TijmenDC1/PE2-herexamen/scriptie en voorstelling/Flight_Controller_Scriptie.docx

Flight Controller

Ontwerp, probleemanalyse en herexamen

PE2

# 1. Inleiding

Wij hebben gekozen voor het ontwerpen van een drone. De drie grote onderdelen van een drone zijn de flight controller, de esc en de motor. De motors hebben we aangekocht de andere twee waren de bedoeling om zelf te ontwikkelen. Doorheen het semester hebben we bij beide onze problemen gehad. Er is uiteindelijk besloten om voor de herkansing in augustus te gaan voor het werkende krijgen van de flight controller en ook de esc modules aan te kopen. Ondanks dat dit een teleurstelling is zullen we in deze scriptie de esc als module nog wel aanhalen maar de eigen ontwikkeling ervan aan de kant laten.

Voor de flight controller, het brein hebben we gekozen om 2 opties te voorzien voor onze drone aan te sturen namelijk autonoom alsook met behulp van een controller beide met hun specifieke benodigde componenten als 1 gemeenschappelijke zijnde de gyroscoop.

Dit document beschrijft achtereenvolgens de gemaakte ontwerpkeuzes, de opbouw van de printplaat, de problemen die tijdens het eerste semester zijn opgetreden en hoe daarmee is omgegaan, en tot slot de voortgang die we hebben weten te boeken tijdens de herexamen periode.

# 2. Functionaliteiten

Om de drone stabiel te houden en beide vliegmodusen te ondersteunen, is de flight controller uitgerust met de volgende functionaliteiten:

### Algemene stabilisatie

### Oorspronkelijk

- BMI330 – IMU met drie accelerometers en drie gyroscopen

Alternatief

- MPU6050 – IMU module drie accelerometers en drie gyroscopen

### Autonoom vliegen

- GPS-module
- Magnetometer
- Barometer
- MicroSD-kaart voor routegegevens

### Vliegen met een controller

- 2,4 GHz-transceiver met bijhorende antenne
- Gebruik van enkele sensoren die grotendeels ook voor autonoom worden gebruikt

# 3. Ontwerpkeuzes

## 3.1 Microcontroller: STM32

Voor de verwerking van alle sensordata is gekozen voor de STM32F745VGT6. Tijdens de research zijn verschillende microcontrollers vergeleken die vaak worden toegepast in flight controllers, waaronder de lichtere STM32F411 en de krachtigere STM32H743. Uiteindelijk is de F7-variant gekozen om voldoende rekenkracht te garanderen voor de PID-regellussen en de bijhorende berekeningen. De H7 was ten eerste ontzettend duur en echt overkill voor wat wij zouden nodig hebben.

Achteraf bleek de STM32F7 ruim voldoende capaciteit te bieden voor de toepassing. Voor een toekomstige versie zou een lichtere en goedkopere chip, zoals de STM32F411, waarschijnlijk zeker hebben volstaan.

## 3.2 Sensoren

Om de drone te kunnen stabiliseren en autonoom te laten navigeren, zijn de volgende sensoren op de flight controller geïntegreerd:

Gyroscoop: voor de PID-loop en de algemene stabilisatie van de drone zijn we uiteindelijk beland bij de MPU6050 (lees paragraaf 5.4 Overstap naar de MPU6050)

Magnetometer: voor autonome navigatie is een kompas onmisbaar om de vliegrichting te bepalen. Hiervoor is de Bosch BMM350 toegepast.

Barometer: om tijdens autonome vluchten de hoogte te bepalen, maakt de flight controller gebruik van de Bosch BMP384. Deze sensor werkt op de nieuwste print wel maar we hebben geen tijd gehad om deze nog te integreren.

GPS-module: voor positionering is gekozen voor de U-blox DAN-F10N. Deze module beschikt over een geïntegreerde antenne, waardoor geen aparte antenne en RF-ontvanger op de printplaat nodig zijn. Deze is pas later aangekomen en om toch te kunnen beginnen in de vakantie is besloten om even zonder deze verder te gaan.

## 3.3 Communicatie

Voor de communicatie met de afstandsbediening is de SX1280-chip toegepast. Deze chip ondersteunt het ExpressLRS-protocol (ELRS). Deze draaien we op het LORA (long range) principe. Het is een open source protocol ontworpen voor FPV-drones. Het geeft ook de mogelijkheid om feedback van op de drone terug te sturen naar de antenne. Om de communicatie van onze drone tot stand te brengen hebben we op school gemeten met de spectrum analyzer en zagen we dat er 2.4GHz werd uitgezonden we wisten op basis hiervan dat de chip “leefde” waardoor we verder konden ontwikkelen. Dit is op het oorspronkelijke bord nooit gelukt om aan te tonen.

## 3.4 Batterij

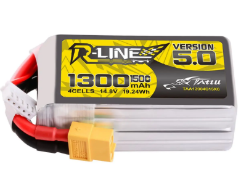
[picture p10: figure]

Om een batterij te kiezen moesten we rekening houden met enkele dingen. De belangrijkste waren de AAD (average amp Draw), AUW (all up weight) en de tijd. De tijd was natuurlijk flexibel maar het mag ook niet te kort zijn want we wouden wel een deftige vluchttijd. De andere 2 waren op voorhand moeilijk exact te bepalen zonder de componenten exact te weten en parameters zoals frame gewicht nog niet in te kunnen brengen. We vonden online enkele formules zoals: tijd = (capaciteit * discharge) / AAD en AAD = (AUW * P) / V waarbij V de nominale batterij spanning is en P het vermogen per kilogram opstijg gewicht. Dat laatste vonden we online namelijk 170 W/KG. Na een gewichtsinschatting te doen kwamen we bij een gewicht van 623g. We wouden een vliegtijd van 10 min halen wat ons op een nominale spanning van ongeveer 15 volt kwam waardoor we op een 4s LIPo batterij kwamen. (het uiteindelijke gewicht kwam uit op net geen 500 gram.)

## 3.5 Motors en propellors

De KV-waarde van een brushless dc motor (uitgedrukt in RPM/volt) geeft aan hoeveel toeren per minuut de motor onbelast draait per volt aangelegde spanning. Deze waarde is een directe ontwerpparameter: ze bepaalt in grote mate of een motor geschikt is voor snelle, wendbare toepassingen dan wel voor toepassingen met veel stuwkracht bij lagere toerentallen.

Onze kv waarde werd dus berekend met de door de batterij geleverde spanning, nominaal 14.8v. De vraag was nu hoeveel RPM we nodig hadden. Hier is de grote en hoeveelheid spaken van de propollors ook van belang. Uiteindelijk is het geen exacte wetenschap met 1 exact antwoord. Maar aangeizen kleine propellors met hoog toerental vooral nodig is voor pure snelheid en het omgekeerde voor stabiele vlucht hebben we gekozen voor een middenweg. We hebben uiteinlijk motors van 2400KV gekocht en propellors met 3 bladen.

## 3.6 ESC’s

Zoals eerder vermeld was het oorspronkelijk de bedoeling om onze eigen ESC’s te ontwikkelen. Jammer genoeg is dat niet geluk. Hoewel het aangetoond is dat het kan werken (enkele seconden) is het niet gelukt om dit consistent te laten draaien doordat we de interne buck converter van de stspin32f0a niet aan de praat kregen. Hierdoor is gekozen om ons in de herexamen te focussen op de flight controller. We zijn dan voor esc modules van aliexpress gegaan.

# 4. PCB ontwerp

# 4.1 Beschrijving

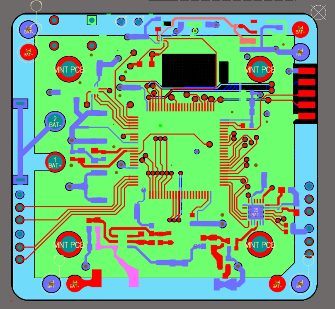
[picture p11: figure]

We hebben gekozen voor een 4 laags PCB. Dit had enkele redenen. De eerste en belangrijkste reden was om verschillende powerplanes te hebben er loopt namelijk heel wat stroom door de flight controller aangezien de esc’s ook gevoed worden vanop de FC. Het maakte het ook mogelijk om een compact design te maken wat voor een drone van uitermate belang is. Bij dit compact design kwam dan als extra voordeel dat het ook minder gewicht met zich mee bracht. Hiernaast staat een voorbeeld van 1 van de planes.

# 4.2 Schemas

In onderstaande afbeelding kan u alles sheets van het schema bekijken maar dit zijn de aansluitingen van eerder vernoemde sensors. In deze paragraaf zou ik graag verder ingaan op de power schema’s. We zien in bijlage 2 een twee traps voeding keten. De eerste trap gaan we van de batterij spanning naar de 3.3volt voedingspanning voor het over grote deel van onze fc. De esc’s worden hier trouwens niet aan verbonden dit gebeurd via de fc maar is wel op de batterij spanning. Het eerste wat we zien na de connector is een diode, deze wordt gebruikt als polariteitsbescherming om de rest van de schakeling te beschermen tegen schade bij bijvoorbeeld foutief aansluiten van de batterij. Dan zien we de effectieve buck converter. Deze werkt doordat een interne transistor razendsnel “af” en “aan” gaat door een pwm signaal aan de gate. De energie word tussendoor opgeslagen door de spoel. Als de transistor aan staat zal de stroom lineair opbouwen over de spoel en als deze af staat zal de spoel deze plotse verandering tegen gaan door stroom terug te leveren uit zijn magnetisch veld. Dit word dan nog eens afgevlakt door een condensator waardoor er een mooie vlakke spanning van 3.3 volt ontstaat.

Voor de gps-module hebben we 1.8 volt nodig omdat de trap tussen 3.3 volt en 1.8 volt niet zo groot is gebruiken we een ldo. Deze zet via een transistor en een feedback loop een vaste 1.8 volt op de uitgang het overige vermogen wordt via warmte weg gereguleerd. Als we dus veel vermogen nodig hebben zou dit niet rendabel zijn omdat we dan veel hitte ontwikkelen en onze batterij te rap leeg trekken.

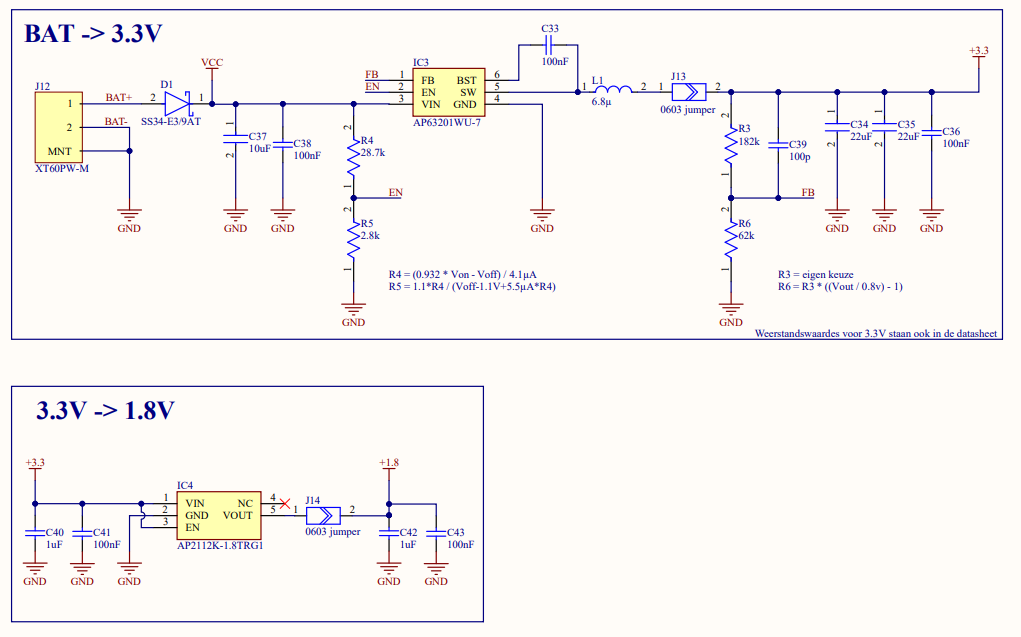
[picture p12: figure]
Afbeelding met tekst, diagram, Plan, lijn Door AI gegenereerde inhoud is mogelijk onjuist.

# 5. Problemen en troubleshooting – eerste semester

Tijdens de bouw en het testen van de printplaat is een reeks problemen aan het licht gekomen. Onderstaand overzicht beschrijft deze problemen, de oorzaak ervan en de manier waarop ze zijn aangepakt.

## 5.1 Voeding en de buck-converter

Bij het eerste testen van de printplaat bleek er geen 3,3V op het bord aanwezig te zijn. Aangezien deze spanning bijna alle sensoren en de STM32 voedt, functioneerde de print hierdoor volledig niet.

Na het testen wees uit dat dit werd veroorzaakt door een verkeerd gekozen spoel na de buck-converter. De oorspronkelijk gekozen spoel had een saturatiestroom van slechts 60 mA, terwijl de print in normaal werking al meer stroom vraagt. Om toch te kunnen testen, is de 3,3V-spanning gedurende lange tijd extern geïnjecteerd.

Bij het bestellen van een vervangende spoel is bovendien per ongeluk een metrische in plaats van een imperial 0603-behuizing besteld, waardoor in werkelijkheid een 0201-spoel werd geleverd die niet bruikbaar was. Na het bestellen van de juiste spoelen werkte de voeding naar verwachting.

## 5.2 Het 14V-incident en schade aan componenten

Tijdens het handmatig injecteren van de 3,3V-testspanning is een fout gemaakt waarbij per ongeluk tweemaal 14V op de 3,3V-voedingsrail werd gezet.

De aanwezige sensoren – de BMI330, de BMM350, de BMP384 en de GPS-module – hebben een absolute maximale spanning die ver onder deze 14V ligt. Als gevolg van dit incident zijn de geïntegreerde sensoren op de printplaat onbruikbaar geworden.

## 5.4 Overstap naar een MPU6050-module

Zoals in de functionaliteiten te lezen valt hebben we op ons bord een BMI330 voorzien echter hebben we deze tijdens de test fase beschadigd waardoor we deze niet meer konden gebruiken. De levertermijn voor deze was ontzettend ver en zelfs voor de herkansing in augustus was dit geen optie. Dankzij de tussenkomst van de docent is er gegaan voor een MPU6050 op een module ondanks dat deze chip niet meer gemaakt word is er wel een enorme hoeveelheid aan modules met deze chip op beschikbaar. Deze hebben we dan ook gesoldeerd op een I2C pin van de controller. Het grootste nadeel hieraan is dat we deze dus zo stevig en zo recht mogelijk aan het frame monteren. Of als alternatief op het recht monteren en kalibratie uitvoeren voor de vlucht.

## 5.5 Gespiegelde ST-Link footprint

Bij het ontwerpen van de footprint voor de ST-Link is de pinout gespiegeld aangebracht. Hierdoor was achteraf een extra tussenstuk nodig om de ST-Link met de STM32 te kunnen laten communiceren.

# 6. Herexamen ontwikkeling

Na het eerste semester is in het kader van het herexamen verder gewerkt aan een werkende flight controller op basis van de MPU6050 als vervangende IMU, met DShot als aansturingsprotocol voor de esc’s. Hieronder volgt een overzicht van de problemen die tijdens deze fase zijn opgetreden, telkens met het symptoom, de oorzaak en de gehanteerde oplossing.

6.1 PID

De stabilisatie van onze drone gebeurt met behulp van een PID controller. Deze code hadden we ook al ontwikkeld tijdens het semester. Oorspronkelijk hadden we 4 loops. De 3 voor de hand liggende zoals de pitch, yaw en roll van de drone dit doen we met de IMU op de drone aanwezig. We hadden er ook nog 1 voorzien voor de hoogte zeker voor het autonoom te laten vliegen is dit zeer handig en bijna essentieel, echter hadden we hier geen tijd meer voor.

Het principe van een PID-regelaar is dat op elk moment een fout (error) wordt berekend als het verschil tussen de gewenste waarde (setpoint) en de werkelijk gemeten waarde. Deze wordt dan via 3 verschillende kanalen bepaald.

- P-term (Proportioneel): reageert onmiddellijk en proportioneel op de huidige fout. Een grote afwijking levert een grote correctie op, een kleine afwijking een kleine correctie. De P-term zorgt voor de basisreactiesnelheid van de regelaar, maar kan bij een te hoge waarde leiden tot overshoot en oscillaties.
- I-term (Integrerend): houdt de opbouw van de fout over tijd bij en corrigeert voor kleine, blijvende afwijkingen die de P-term alleen niet wegwerkt. Een te hoge I-term veroorzaakt echter een trage, slingerende reactie (windup).
- D-term (Differentiërend): kijkt naar de snelheid waarmee de fout verandert en werkt dempend: ze remt de correctie af naarmate het setpoint wordt benaderd, wat overshoot en oscillaties helpt onderdrukken. Een te hoge D-term maakt de regelaar echter gevoelig voor sensorruis.

De som van deze drie termen, elk vermenigvuldigd met een eigen versterkingsfactor (Kp, Ki en Kd), bepaalt de uiteindelijke stuuruitgang die aan de motoren wordt doorgegeven via de mixer.

Van PID-uitgang naar motoraansturing

De uitgangswaarden van de drie PID-regelaars (voor roll, pitch en yaw) worden samen met de throttle-waarde van de controller/sd kaart doorgegeven aan de motormixer. Deze mixer verdeelt de correcties over de vier motoren. Het resultaat van deze mixer wordt uiteindelijk als DShot-frame naar de ESC's van elke motor gestuurd.

6.2 DSHOT/ESC

Om verder te gaan op de ESC-modules moesten we in essentie een DShot-protocol bit-bangen om de ESC's aan te sturen. Deze code werd doorheen het semester geschreven en uitvoerig getest, maar leverde nooit het gewenste resultaat op: de motoren draaiden niet consistent en niet op de momenten die verwacht werden.

Metingen met behulp van een logic analyzer en oscilloscoop toonde echter aan dat de door de STM32 uitgestuurde data wel degelijk correct was en overeenkwam met de verwachte DShot-timing. Om dit verder te bevestigen, werd dezelfde code getest via een ESP32, waar de motoren wel naar behoren functioneerden, ondanks dat de uitgestuurde data, gemeten met dezelfde logic analyzer, identiek was aan die van de STM32. Dezelfde data resulteerde dus in een ander resultaat, afhankelijk van de gebruikte microcontroller.

Na het bestukken van een nieuwe print werkte de aansturing wel naar behoren. We weten niet waaraan het zou kunnen liggen dat de oude print het niet werkende kreeg. We weten dat er overspanning is geweest maar dit had geen invloed op de werking van het dshot protocol normaal gezien. Een echte verklaring kunnen we dan ook niet geven.

6.3 Code van de MPU6050

Ook deze code was al in het semester geschreven en deze werkte maar kon in deze periode dankzij de werkende motors geïmplementeerd worden in de PID-loop.

6.4 ESC’s

Door verder te gaan op de ESC modules moesten we eigenlijk enkel een dshot code bitbangen die we konden gebruiken om de esc’s aan te sturen. We hebben deze code geschreven en getest echter werkte dit niet zoals verwacht. De motors draaide niet consistent en niet op de momenten dat we wouden. We hebben dezelfde code dan getest via een ESP32 en dit bleek wel naar behoren te werken. Na het uitmeten met de logic analyzer konden we aantonen dat de data die onze stm uitstuurde wel degelijk ook correct was en zelfs overeen kwam met de data die uit de esp kwam. Dezelfde data maar dus met een ander resultaat. Na dit enkele weken aan de kant te hebben laten staan hebben we dit opnieuw getest en zonder grote aantoonbare aanpassingen werkt dit plots wel. We zouden dit kunnen classificeren als de zwarte magie die elektronica soms is maar in realiteit zal het ergens een minuscuul foutje zijn geweest dat we onbedoeld maar zeer welkom hebben opgelost. We vermoeden een timing fout maar kunnen dus niet achterhalen wat dit geweest is.

6.5 TX/RX probleem

De TX pin op de stm was afgebroken en hierdoor konden we printf niet meer gebruiken, de oplossing was RX/TX Pin swapping aanzetten in de IOC.

6.6 STlink kortsluiting

Om het programmeren sneller te laten gaan hadden we besloten dat Tijmen op de oude print de sd kaart ging testen. Simon heeft toen de stlink van Robbe geleend echter toen deze werd aangesloten begonnen de motoren heel vreemd en hard te draaien. Hierna bleek er kortsluiting te zijn op de print. De stm is dan terug vervangen moeten worden en een kapotte condensator gaf ook een probleem. De kortsluiting bleef aanwezig op het bord en dus hebben we besloten om een nieuwe print te bestukken.

# 7. Conclusie
