TijmenDC1/PE2-herexamen/Drone Frame/droneV3.3mf

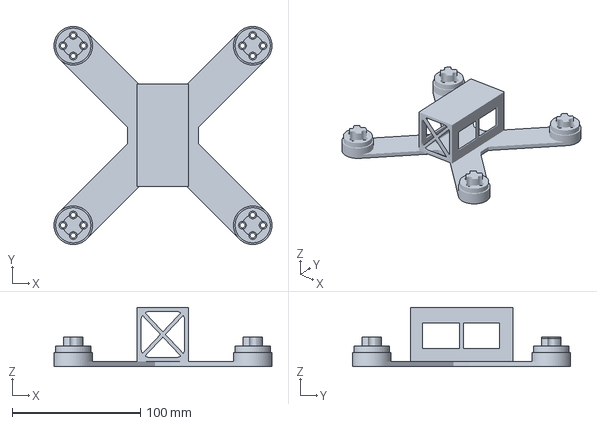
[picture p13: CAD file, 2026-08-20]
Drone Frame/droneV3.3mf
169.9 x 169.9 x 46.0 mm
