TijmenDC1/PE2-herexamen/Drone Frame/Configuration 1.3mf

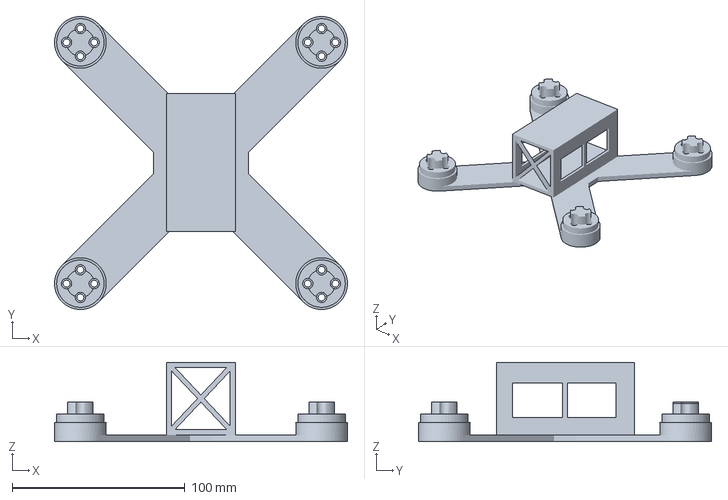
[picture p14: CAD file, 2026-08-19]
Drone Frame/Configuration 1.3mf
169.9 x 169.9 x 46.0 mm
