TijmenDC1/PE2-herexamen/(list of files, cad)

Other CAD files:
Drone Frame/droneTestv2.f3z
Drone Frame/droneframev3.f3z
