TijmenDC1/PE2-herexamen/scriptie en voorstelling/FC/FC2.pdf

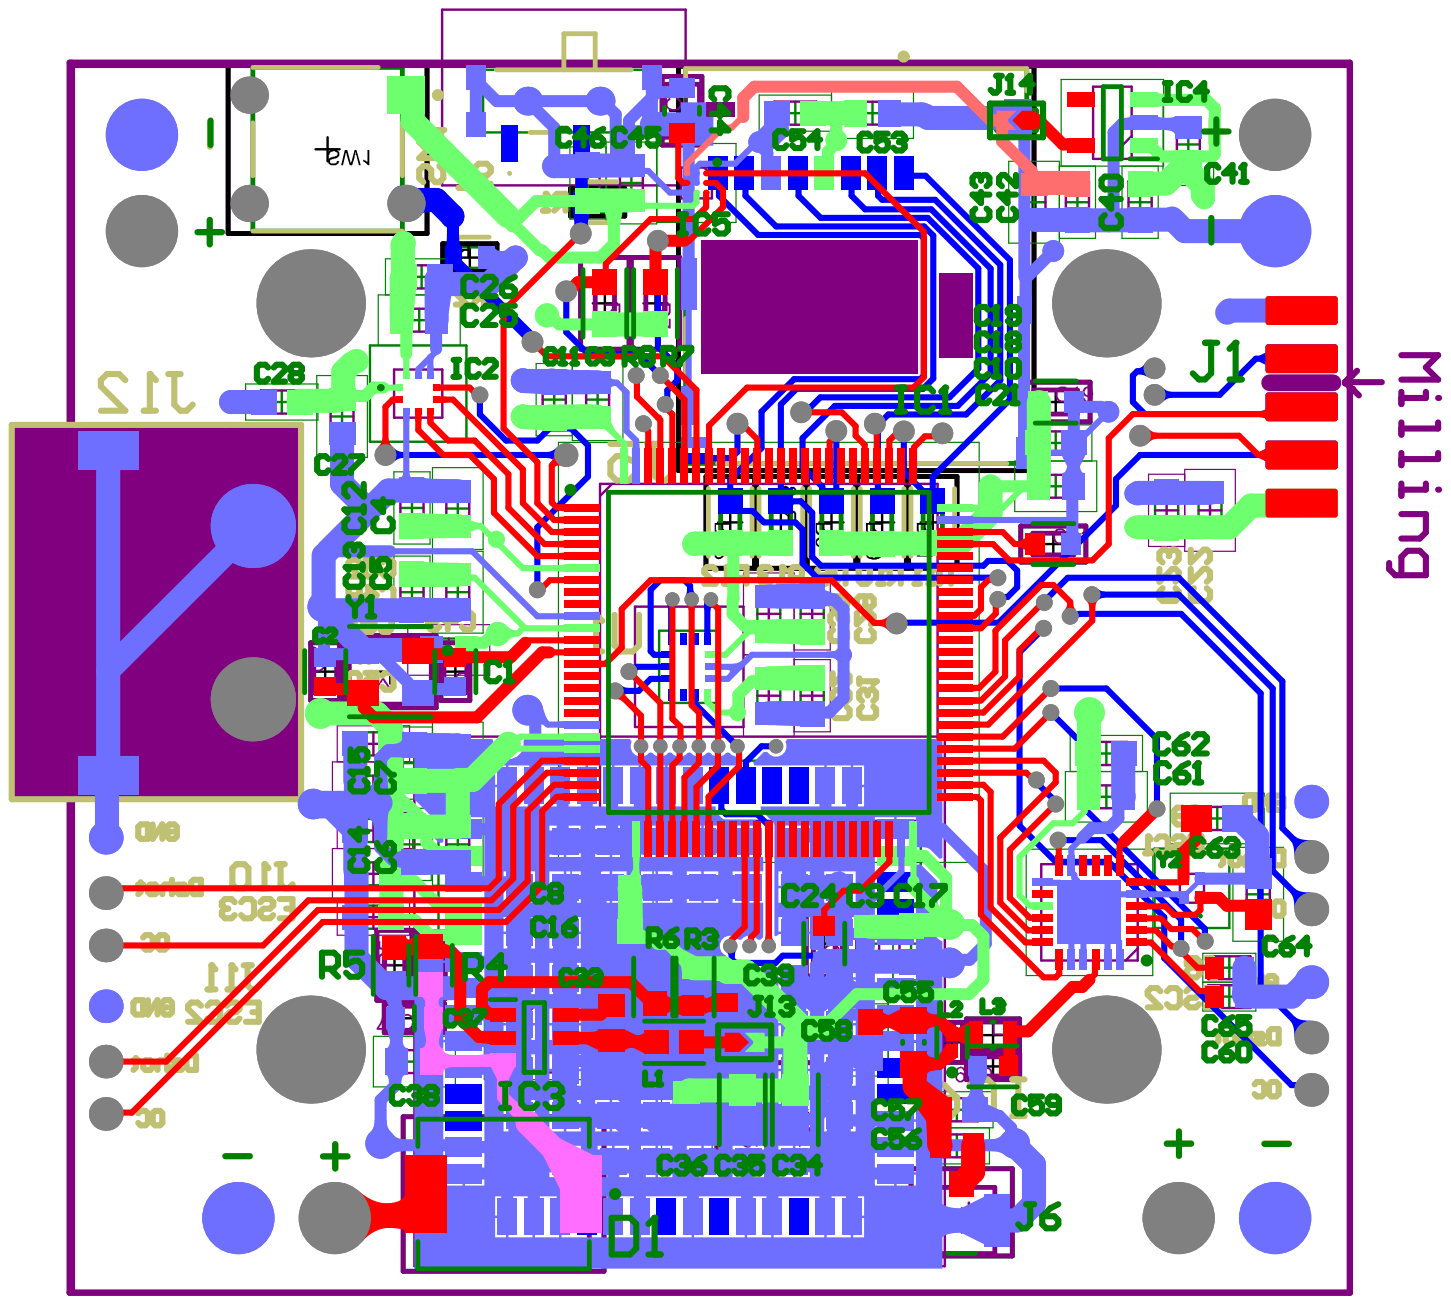
[picture p15: page 1]

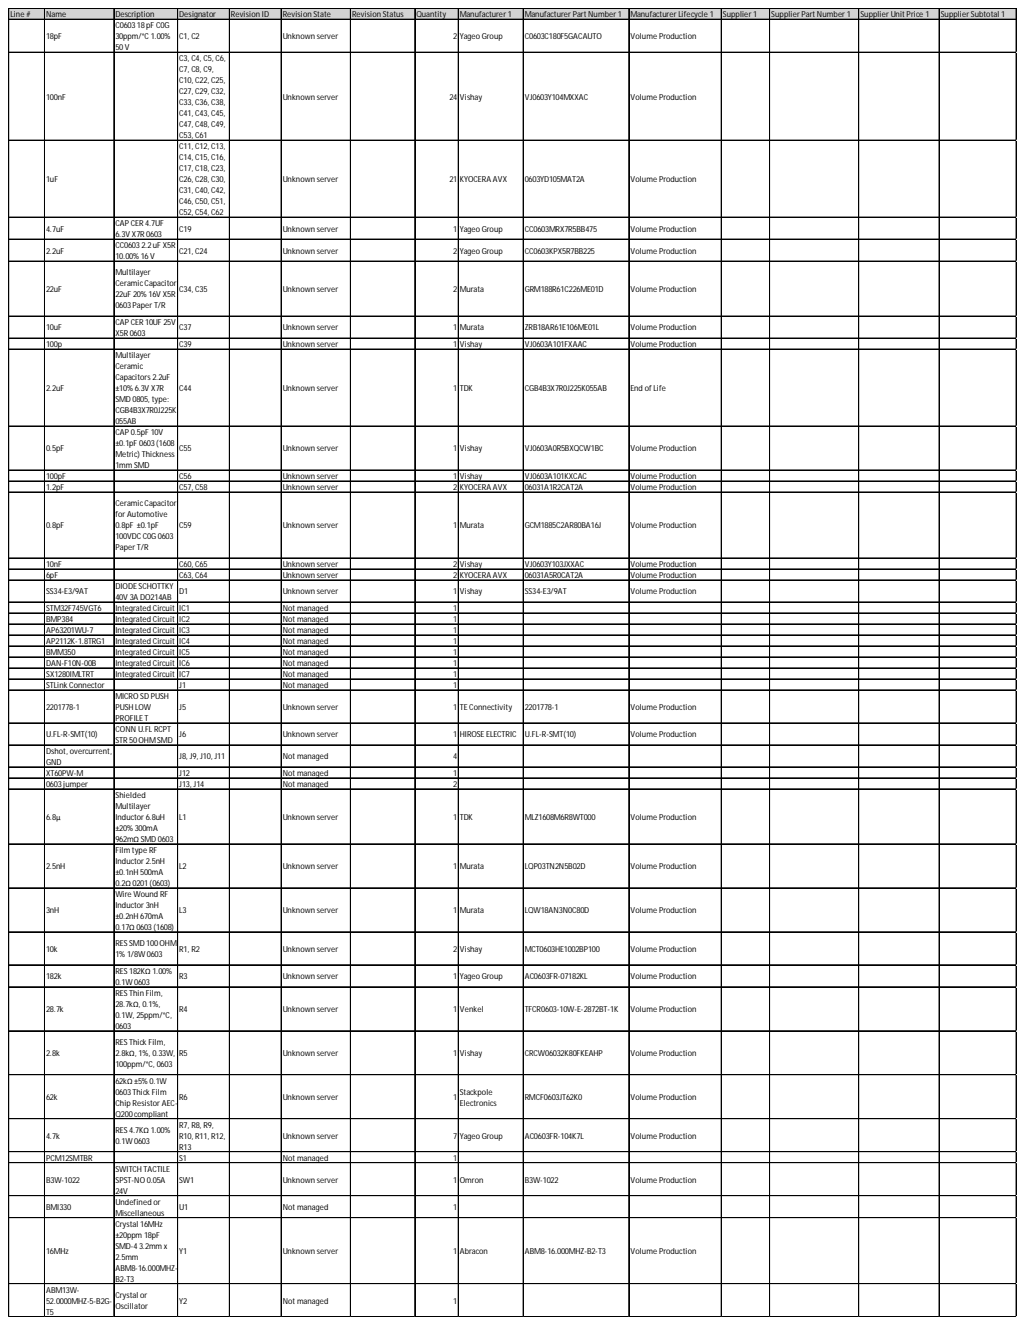
[picture p16: page 2]

Line # | Name | Description | Designator | Revision ID | Revision State | Revision Status | Quantity | Manufacturer 1 | Manufacturer Part Number 1 | Manufacturer Lifecycle 1 | Supplier 1 | Supplier Part Number 1 | Supplier Unit Price 1 | Supplier Subtotal 1

18pF | C0603 18 pF C0G 30ppm/°C 1.00% 50 V | C1, C2 | | Unknown server | | 2 Yageo Group | | C0603C180F5GACAUTO | Volume Production

100nF | | C3, C4, C5, C6, C7, C8, C9, C10, C22, C25, C27, C29, C32, C33, C36, C38, C41, C43, C45, C47, C48, C49, C53, C61 | | Unknown server | | 24 Vishay | | VJ0603Y104MXXAC | Volume Production

1uF | | C11, C12, C13, C14, C15, C16, C17, C18, C23, C26, C28, C30, C31, C40, C42, C46, C50, C51, C52, C54, C62 | | Unknown server | | 21 KYOCERA AVX | | 0603YD105MAT2A | Volume Production

4.7uF | CAP CER 4.7UF 6.3V X7R 0603 | C19 | | Unknown server | | 1 Yageo Group | | CC0603MRX7R5BB475 | Volume Production

2.2uF | CC0603 2.2 uF X5R 10.00% 16 V | C21, C24 | | Unknown server | | 2 Yageo Group | | CC0603KPX5R7BB225 | Volume Production

22uF | Multilayer Ceramic Capacitor 22uF 20% 16V X5R 0603 Paper T/R | C34, C35 | | Unknown server | | 2 Murata | | GRM188R61C226ME01D | Volume Production

10uF | CAP CER 10UF 25V X5R 0603 | C37 | | Unknown server | | 1 Murata | | ZRB18AR61E106ME01L | Volume Production

100p | | C39 | | Unknown server | | 1 Vishay | | VJ0603A101FXAAC | Volume Production
2.2uF | Multilayer Ceramic Capacitors 2.2uF ±10% 6.3V X7R SMD 0805, type: CGB4B3X7R0J225K 055AB | C44 | | Unknown server | | 1 TDK | | CGB4B3X7R0J225K055AB | End of Life

0.5pF | CAP 0.5pF 10V ±0.1pF 0603 (1608 Metric) Thickness 1mm SMD | C55 | | Unknown server | | 1 Vishay | | VJ0603A0R5BXQCW1BC | Volume Production

100pF | | C56 | | Unknown server | | 1 Vishay | | VJ0603A101KXCAC | Volume Production
1.2pF | | C57, C58 | | Unknown server | | 2 KYOCERA AVX | | 06031A1R2CAT2A | Volume Production

0.8pF | Ceramic Capacitor for Automotive 0.8pF ±0.1pF 100VDC C0G 0603 Paper T/R | C59 | | Unknown server | | 1 Murata | | GCM1885C2AR80BA16J | Volume Production

10nF | | C60, C65 | | Unknown server | | 2 Vishay | | VJ0603Y103JXXAC | Volume Production
6pF | | C63, C64 | | Unknown server | | 2 KYOCERA AVX | | 06031A5R0CAT2A | Volume Production
SS34-E3/9AT | DIODE SCHOTTKY 40V 3A DO214AB | D1 | | Unknown server | | 1 Vishay | | SS34-E3/9AT | Volume Production

STM32F745VGT6 | Integrated Circuit | IC1 | | Not managed | | 1
BMP384 | Integrated Circuit | IC2 | | Not managed | | 1
AP63201WU-7 | Integrated Circuit | IC3 | | Not managed | | 1
AP2112K-1.8TRG1 | Integrated Circuit | IC4 | | Not managed | | 1
BMM350 | Integrated Circuit | IC5 | | Not managed | | 1
DAN-F10N-00B | Integrated Circuit | IC6 | | Not managed | | 1
SX1280IMLTRT | Integrated Circuit | IC7 | | Not managed | | 1
STLink Connector | | J1 | | Not managed | | 1
2201778-1 | MICRO SD PUSH PUSH LOW PROFILE T | J5 | | Unknown server | | 1 TE Connectivity | | 2201778-1 | Volume Production

U.FL-R-SMT(10) | CONN U.FL RCPT STR 50OHM SMD | J6 | | Unknown server | | 1 HIROSE ELECTRIC | | U.FL-R-SMT(10) | Volume Production

Dshot, overcurrent, GND | | J8, J9, J10, J11 | | Not managed | | 4

XT60PW-M | | J12 | | Not managed | | 1
0603 jumper | | J13, J14 | | Not managed | | 2
6.8µ | Shielded Multilayer Inductor 6.8uH ±20% 300mA 962mΩ SMD 0603 | L1 | | Unknown server | | 1 TDK | | MLZ1608M6R8WT000 | Volume Production

2.5nH | Film type RF Inductor 2.5nH ±0.1nH 500mA 0.2Ω 0201 (0603) | L2 | | Unknown server | | 1 Murata | | LQP03TN2N5B02D | Volume Production

3nH | Wire Wound RF Inductor 3nH ±0.2nH 670mA 0.17Ω 0603 (1608) | L3 | | Unknown server | | 1 Murata | | LQW18AN3N0C80D | Volume Production

10k | RES SMD 100OHM 1% 1/8W 0603 | R1, R2 | | Unknown server | | 2 Vishay | | MCT0603HE1002BP100 | Volume Production

182k | RES 182KΩ 1.00% 0.1W 0603 | R3 | | Unknown server | | 1 Yageo Group | | AC0603FR-07182KL | Volume Production

28.7k | RES Thin Film, 28.7kΩ, 0.1%, 0.1W, 25ppm/°C, 0603 | R4 | | Unknown server | | 1 Venkel | | TFCR0603-10W-E-2872BT-1K | Volume Production

2.8k | RES Thick Film, 2.8kΩ, 1%, 0.33W, 100ppm/°C, 0603 | R5 | | Unknown server | | 1 Vishay | | CRCW06032K80FKEAHP | Volume Production

62k | 62kΩ ±5% 0.1W 0603 Thick Film Chip Resistor AEC-Q200 compliant | R6 | | Unknown server | | 1 Stackpole | Electronics | RMCF0603JT62K0 | Volume Production

4.7k | RES 4.7KΩ 1.00% 0.1W 0603 | R7, R8, R9, R10, R11, R12, R13 | | Unknown server | | 7 Yageo Group | | AC0603FR-104K7L | Volume Production

PCM12SMTBR | | S1 | | Not managed | | 1
B3W-1022 | SWITCH TACTILE SPST-NO 0.05A 24V | SW1 | | Unknown server | | 1 Omron | | B3W-1022 | Volume Production

BMI330 | Undefined or Miscellaneous | U1 | | Not managed | | 1

16MHz | Crystal 16MHz ±20ppm 18pF SMD-4 3.2mm x 2.5mm ABM8-16.000MHZ-B2-T3 | Y1 | | Unknown server | | 1 Abracon | | ABM8-16.000MHZ-B2-T3 | Volume Production

ABM13W-52.0000MHZ-5-B2G-T5 | Crystal or Oscillator | Y2 | | Not managed | | 1
