TijmenDC1/PE2-herexamen/(list of files, drawings)

Other design files:
scriptie en voorstelling/FC/Autonoom.SchDoc
scriptie en voorstelling/FC/Controller.SchDoc
scriptie en voorstelling/FC/FC2.PcbDoc
scriptie en voorstelling/FC/Flight_Controller.PrjPcb
scriptie en voorstelling/FC/PCB1.PcbDoc
scriptie en voorstelling/FC/PCM12SMTBR.SchLib
scriptie en voorstelling/FC/Power.SchDoc
scriptie en voorstelling/FC/Root.SchDoc
scriptie en voorstelling/FC/Sensors.SchDoc
scriptie en voorstelling/FC/STLink Connector.SchLib
scriptie en voorstelling/FC/uController.SchDoc
scriptie en voorstelling/FC/XT60PW-F.PcbLib
scriptie en voorstelling/FC/XT60PW-M.SchLib
