TijmenDC1/PE2-herexamen/code/BMM350v2/BMM350v2.ioc

Mcu.UserName=STM32F745VGTx
PA0/WKUP.GPIO_Label=Dshot M1
PA0/WKUP.Signal=S_TIM2_CH1_ETR
PA1.GPIO_Label=Overcurrent_M1
PA1.Signal=GPIO_Input
PA13.GPIO_Label=STLink_DIO
PA13.Signal=SYS_JTMS-SWDIO
PA14.GPIO_Label=STLink_CLK
PA14.Signal=SYS_JTCK-SWCLK
PA2.GPIO_Label=Dshot M2
PA2.Signal=S_TIM2_CH3
PA3.GPIO_Label=Overcurrent_M2
PA3.Signal=GPIO_Input
PA4.GPIO_Label=BMI_CS
PA4.Signal=GPIO_Output
PA5.GPIO_Label=BMI_SCK
PA5.Signal=SPI1_SCK
PA6.GPIO_Label=BMI_MISO
PA6.Signal=SPI1_MISO
PA7.GPIO_Label=BMI_MOSI
PA7.Signal=SPI1_MOSI
PA8.Signal=RCC_MCO_1
PB12.GPIO_Label=SX1280_CS
PB12.Signal=GPIO_Output
PB13.GPIO_Label=SX1280_SCK
PB13.Signal=SPI2_SCK
PB14.GPIO_Label=SX1280_MISO
PB14.Signal=SPI2_MISO
PB15.GPIO_Label=SX1280_MOSI
PB15.Signal=SPI2_MOSI
PB2.GPIO_Label=GPS_Timer
PB2.Signal=GPIO_Input
PB3.GPIO_Label=SD_SWA
PB3.Signal=GPIO_Input
PB7.GPIO_Label=BMM_INT
PB7.Signal=GPXTI7
PB8.GPIO_Label=BMM_SCL
PB8.Signal=I2C1_SCL
PB9.GPIO_Label=BMM_SDA
PB9.Signal=I2C1_SDA
PC10.GPIO_Label=SD_D2
PC10.Signal=SDMMC1_D2
PC11.GPIO_Label=SD_D3
PC11.Signal=SDMMC1_D3
PC12.GPIO_Label=SD_CK
PC12.Signal=SDMMC1_CK
PC13.GPIO_Label=BMP_INT
PC13.Signal=GPXTI13
PC14/OSC32_IN.Signal=RCC_OSC32_IN
PC15/OSC32_OUT.Signal=RCC_OSC32_OUT
PC4.GPIO_Label=BMI_INT1
PC4.Signal=GPXTI4
PC5.GPIO_Label=BMI_INT2
PC5.Signal=GPXTI5
PC8.GPIO_Label=SD_D0
PC8.Signal=SDMMC1_D0
PC9.GPIO_Label=SD_D1
PC9.Signal=SDMMC1_D1
PD10.GPIO_Label=Overcurrent_M4
PD10.Signal=GPIO_Input
PD11.GPIO_Label=Overcurrent_M3
PD11.Signal=GPIO_Input
PD12.GPIO_Label=Dshot M4
PD12.Signal=S_TIM4_CH1
PD13.GPIO_Label=Dshot M3
PD13.Signal=S_TIM4_CH2
PD2.GPIO_Label=SD_CMD
PD2.Signal=SDMMC1_CMD
PD8.GPIO_Label=SX1280_nRST
PD8.Signal=GPIO_Output
PD9.GPIO_Label=SX1280_Bussy
PD9.Signal=GPIO_Input
PE0.GPIO_Label=STLink_TX
PE0.Signal=UART8_RX
PE1.GPIO_Label=STLink_RX
PE1.Signal=UART8_TX
PE2.GPIO_Label=BMP_SCK
PE2.Signal=SPI4_SCK
PE3.GPIO_Label=Autonoom/Controller
PE3.Signal=GPIO_Input
PE4.GPIO_Label=BMP_CS
PE4.Signal=GPIO_Output
PE5.GPIO_Label=BMP_MISO
PE5.Signal=SPI4_MISO
PE6.GPIO_Label=BMP_MOSI
PE6.Signal=SPI4_MOSI
PE7.GPIO_Label=GPS_RX
PE7.Signal=UART7_RX
PE8.GPIO_Label=GPS_TX
PE8.Signal=UART7_TX
PH0/OSC_IN.Signal=RCC_OSC_IN
PH1/OSC_OUT.Signal=RCC_OSC_OUT
