TijmenDC1/PE2-herexamen/code/sdkaart/Core/Src/main.c

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
/* Includes ------------------------------------------------------------------*/
#include "main.h"
#include "fatfs.h"

/* USER CODE BEGIN Includes */
#include "stdio.h"
//#include "BMP384.h"
//#include "BMM350.h"
//#include "BMI330.h"
//#include "pid_regulator.h"
#include "Flightrun.h"
#include "sdcard.h"
#include "flightplan.h"         /* lezen wat er op een bestand staat  */
#include "flightplan_write.h"   /* een bestand maken en beschrijven   */
/* USER CODE END Includes */


I2C_HandleTypeDef hi2c1;

SD_HandleTypeDef hsd1;

SPI_HandleTypeDef hspi1;
SPI_HandleTypeDef hspi2;
SPI_HandleTypeDef hspi4;

TIM_HandleTypeDef htim2;
TIM_HandleTypeDef htim4;
DMA_HandleTypeDef hdma_tim2_up_ch3;
DMA_HandleTypeDef hdma_tim2_ch1;
DMA_HandleTypeDef hdma_tim4_ch1;
DMA_HandleTypeDef hdma_tim4_ch2;

UART_HandleTypeDef huart7;
UART_HandleTypeDef huart8;

/* USER CODE BEGIN PV */
//BMP384_Calib calibData;
/*
PID_Handle_t struct_PidRateRoll;
PID_Handle_t struct_PidRatePitch;
PID_Handle_t struct_PidRateYaw;
BMM350_MagData BMM350_Data;
BMI330_Frame current_data;
*/

float g_hoogte;
float g_druk;
float g_hoek;
int g_acc;
int g_gyr;
float alpha = 0.98; // hoe hoger hoe meer de acc gaat doortellen
float dt = 0.02;   // voor 50hz
float gefilterde_hoogte = 0;
float verticale_snelheid = 0;
/* USER CODE END PV */

void SystemClock_Config(void);
static void MPU_Config(void);
static void MX_GPIO_Init(void);
static void MX_DMA_Init(void);
static void MX_I2C1_Init(void);
static void MX_SDMMC1_SD_Init(void);
static void MX_SPI1_Init(void);
static void MX_SPI2_Init(void);
static void MX_SPI4_Init(void);
static void MX_TIM2_Init(void);
static void MX_TIM4_Init(void);
static void MX_UART7_Init(void);
static void MX_UART8_Init(void);
/* USER CODE BEGIN PFP */
static void schrijf_vluchtplan(void);
/* USER CODE END PFP */

/* USER CODE BEGIN 0 */

int g_new_pressure_data = 0;

/* ==========================================================================
 * Vluchtplan: schrijven, uitlezen, vliegen
 *
 * Het plan zelf staat hieronder als FlightCmd_t-array. Zet de drie vlaggen
 * naar wat je nu wil doen.
 * ========================================================================== */

/* 1) SCHRIJVEN. Zet het plan hieronder op de SD-kaart. Na de eerste geslaagde
 *    flash+run mag dit op 0, anders wordt de kaart bij elke boot overschreven. */
#define WRITE_FLIGHTPLAN_TO_SD  1

/* 2) UITLEZEN. Leest het plan terug van de kaart en print het genummerd over
 *    UART8, met validatie. Zo zie je precies wat de drone gaat doen. Laat dit
 *    gerust op 1 staan, het kost alleen wat opstarttijd. */
#define DUMP_FLIGHTPLAN_FROM_SD 1

/* 3) VLIEGEN. Op 0 doet het bord alleen schrijven en uitlezen, en blijven de
 *    motoren gegarandeerd uit: FlightControl_Init() armt de ESC's dan nooit.
 *    Zo test je de hele SD-keten veilig. Zet dit pas op 1 als de dump hierboven
 *    er goed uitziet, en dan nog eerst zonder propellers. */
#define RUN_FLIGHTPLAN          0

/* Print bij het uitlezen ook de ruwe bytes van het bestand, zodat je ziet dat
 * er echt iets op de kaart staat en niet alleen in RAM. */
#define DUMP_FLIGHTPLAN_RAW     1

/* --------------------------------------------------------------------------
 * Het vluchtplan
 *
 * Throttle <procent 0-100> <ms>   0 % = THROTTLE_MIN, 100 % = THROTTLE_MAX
 * Hover    <ms>                   houdt de huidige throttle aan
 * Left     <ms>                   kantelt LEFT_RIGHT_TILT_DEG naar links
 * Right    <ms>                   idem naar rechts
 * Land                            bouwt de throttle af en zet de motoren uit
 *
 * RelativeHeight / AbsoluteHeight / Move worden wel geschreven en ingelezen,
 * maar flightcontrol.c slaat ze nog over: die hebben de barometer en GPS nodig.
 *
 * TEST DIT EERST ZONDER PROPELLERS, of met het frame vastgezet op een
 * teststaaf. FlightControl_Init() kalibreert de gyro en het level: het frame
 * moet dan stil en waterpas liggen (volg de printf's over UART8).
 * -------------------------------------------------------------------------- */
static const FlightCmd_t mijn_plan[] = {
    { CMD_THROTTLE, { 30.0f, 2000.0f, 0.0f } },   /* rustig aanlopen            */
    { CMD_THROTTLE, { 40.0f, 3000.0f, 0.0f } },   /* ~THROTTLE_BASE             */
    { CMD_LEFT,     { 1000.0f, 0.0f, 0.0f } },    /* kantelrichting controleren */
    { CMD_RIGHT,    { 1000.0f, 0.0f, 0.0f } },
    { CMD_THROTTLE, { 35.0f, 1500.0f, 0.0f } },   /* rustig voor de landing     */
    { CMD_LAND,     { 0.0f, 0.0f, 0.0f } },
};

/* Maakt het bestand aan op de kaart en schrijft het plan hierboven erin.
 * FlightPlan_Save valideert eerst, dus een fout plan raakt de kaart niet, en
 * leest daarna byte voor byte terug of er echt staat wat we bedoelden.
 *
 * Wil je meerdere plannen op de kaart, zet er dan een tweede array naast en
 * roep FlightPlan_Save nog een keer aan met een andere bestandsnaam. Houd die
 * naam op 8.3 (max 8 tekens voor de punt): met de standaardinstelling van
 * FATFS staan lange bestandsnamen uit. */
static void schrijf_vluchtplan(void)
{
    if (SDCard_Mount() != SDCARD_OK) {
        printf("kon de SD-kaart niet mounten, er is niets geschreven\n");
        return;
    }
    FlightPlan_Save(mijn_plan, FLIGHTPLAN_AANTAL(mijn_plan), FLIGHTPLAN_ACTIVE_FILE);
    SDCard_Unmount();
}

int _write(int file, char *ptr, int len) {
	for(int i = 0; i < len; i++){
		if(ptr[i]=='\n'){
			HAL_UART_Transmit(&huart8, (uint8_t*)"\r", 1, HAL_MAX_DELAY);
		}
		HAL_UART_Transmit(&huart8, (uint8_t*)&ptr[i], 1, HAL_MAX_DELAY);
	}
    return len;
}
/*
void Update_Altitude_Filter(float baro_hoogte, float acc_z_m_s2) {
    verticale_snelheid += acc_z_m_s2 * dt;
    float voorspelde_hoogte = gefilterde_hoogte + (verticale_snelheid * dt);
    gefilterde_hoogte = (alpha * voorspelde_hoogte) + ((1 - alpha) * baro_hoogte);
}
*/
/* USER CODE END 0 */

/**
  * @brief  The application entry point.
  * @retval int
  */
int main(void)
{

  /* MPU Configuration--------------------------------------------------------*/
  MPU_Config();

  /* MCU Configuration--------------------------------------------------------*/

  /* Reset of all peripherals, Initializes the Flash interface and the Systick. */
  HAL_Init();

  /* USER CODE BEGIN Init */
 /* Init_RateLoops();
  BMM350_Init();
  PID_HandleInit(struct_PidRateRoll);
  PID_HandleInit(struct_PidRatePitch);
  PID_HandleInit(struct_PidRateYaw);
  */
  //BMI330_Init();
  /* USER CODE END Init */

  /* Configure the system clock */
  SystemClock_Config();

  /* Initialize all configured peripherals */
  MX_GPIO_Init();
  MX_DMA_Init();
  MX_I2C1_Init();
  MX_SDMMC1_SD_Init();
  MX_SPI1_Init();
  MX_SPI2_Init();
  MX_SPI4_Init();
  MX_TIM2_Init();
  MX_TIM4_Init();
  MX_UART7_Init();
  MX_FATFS_Init();
  MX_UART8_Init();
  /* USER CODE BEGIN 2 */

  /* ---- UART-CHECK ----------------------------------------------------------
   * Gaat rechtstreeks naar UART8, zonder printf, zonder newlib, zonder SD-kaart.
   * Dit is het allereerste wat er gebeurt na de peripheral-init.
   *
   *   zie je dit WEL maar de rest niet -> probleem zit in printf of in de code erna
   *   zie je dit NIET                   -> bedrading, baudrate of COM-poort
   *
   * Stond op 1 tijdens het zoeken naar de stille UART (bleek de RX/TX-swap te
   * zijn). Zet hem terug op 1 als je ooit weer niets binnenkrijgt: hij kost
   * 2 seconden bij het opstarten en zegt je meteen of de lijn zelf goed zit. */
#define UART_CHECK 0
#if UART_CHECK
  for (int i = 0; i < 10; i++) {
      HAL_UART_Transmit(&huart8, (uint8_t *)"UART8 werkt\r\n", 13, HAL_MAX_DELAY);
      HAL_Delay(200);
  }
#endif

  /* printf niet laten bufferen: elke regel gaat meteen de lijn op, ook als het
   * bord daarna vastloopt of in een failsafe belandt. */
  setvbuf(stdout, NULL, _IONBF, 0);

  //BMP384_Init(&calibData);

  printf("\n\n===== opgestart, vluchtplan-test =====\n");

#if WRITE_FLIGHTPLAN_TO_SD
  /* SCHRIJVEN: het plan uit mijn_plan[] -> SD-kaart, met validatie en
   * terugleescontrole. Zie schrijf_vluchtplan() hierboven. */
  printf("\n[1] SCHRIJVEN\n");
  schrijf_vluchtplan();
#endif

#if DUMP_FLIGHTPLAN_FROM_SD
  /* UITLEZEN: SD-kaart -> RAM -> genummerd over UART8, met validatie. Staat
   * DUMP_FLIGHTPLAN_RAW op 1, dan komen ook de ruwe bytes van het bestand
   * voorbij. FlightPlan_Show mount en unmount zelf. */
  printf("\n[2] UITLEZEN EN CONTROLEREN\n");
  FlightPlan_Show(FLIGHTPLAN_ACTIVE_FILE, DUMP_FLIGHTPLAN_RAW);
#endif

#if RUN_FLIGHTPLAN
  FlightRun_Execute(); // mount SD, laadt het plan, initialiseert PID/MPU6050 en voert het uit
#else
  printf("RUN_FLIGHTPLAN staat op 0: motoren blijven uit, er wordt niet gevlogen\n");
#endif
  /* USER CODE END 2 */

  /* Infinite loop */
  /* USER CODE BEGIN WHILE */
  while (1)
  {
	  //float pressure_pa = BMP384_ReadData(&calibData); // in pascal
	  	//	  float hoogte = BMP384_CalculateAltitude(pressure_pa);
	  		//  float temp = BMP384_GetTemp(&calibData);
	  		  //printf("BMP284:\r\n De druk(pa) = %f\nDe hoogte(m) = %f, De temp = %f\n", pressure_pa, hoogte, temp);
	  //if(g_new_pressure_data == 1){
		//  float pressure_pa = BMP384_ReadData(&calibData); // in pascal
		  //float hoogte = BMP384_CalculateAltitude(pressure_pa);
		  //float temp = BMP384_GetTemp(&calibData);
		  //printf("BMP284:\r\n De druk(pa) = %f\nDe hoogte(m) = %f, De temp = %f\n", pressure_pa, hoogte, temp);
		 // printf("BMP284:\r\n De druk(pa) = %f\n", pressure_pa);
		//  g_new_pressure_data = 0;
	  //}
    /* USER CODE END WHILE */

    /* USER CODE BEGIN 3 */

  }
  /* USER CODE END 3 */
}

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
/* USER CODE BEGIN 4 */
/*
void Update_Motors(uint16_t throttle, int16_t roll, int16_t pitch, int16_t yaw) {
    int16_t m1 = throttle + pitch + roll - yaw; // Linksvoor
    int16_t m2 = throttle + pitch - roll + yaw; // Rechtsvoor
    int16_t m3 = throttle - pitch + roll + yaw; // Linksachter
    int16_t m4 = throttle - pitch - roll - yaw; // Rechtsachter
}
*/
void HAL_GPIO_EXTI_Callback(uint16_t GPIO_Pin)
{
/*
    if (GPIO_Pin == GPIO_PIN_4)	//INT1 van BMI
    {
    	float data[15];
    	int len = 15;
    	float roll, pitch;
    	BMI330_ReadFIFO(data, len);
    	BMI330_ParseFIFOFrame(&data, &current_data);
    	BMI330_GetAngles(current_data, roll, pitch);

    	printf("Data van de BMI INT1 pin: \n");
    	printf("Gyro data: X = %f, Y = %f, Z = %f \n", current_data->gyr_x, current_data->gyr_y, current_data->gyr_z);
    	printf("acc  data: X = %f, Y = %f, Z = %f \n", current_data->acc_x, current_data->acc_y, current_data->acc_z);
    	printf("temp: %f \n\n\n\n", current_data->sensor_temp);
    	g_temp = current_data->sensor_temp;
    	g_roll = roll;
    	g_pitch = pitch;
    	return;
    }

    if (GPIO_Pin == GPIO_PIN_5)	//INT2 van BMI
    {
    	return;
    }
    if (GPIO_Pin == GPIO_PIN_7)	//INT van BMM350
    {
    	float roll, pitch;
    	BMI330_GetAngles(current_data, &roll, &pitch);
    	BMM350_GetData(&BMM350_Data, roll, pitch);
    	float hoek = BMM350_Data.richting;

    	// calibrate is iets wat we eenmalig moeten doen, hieruit halen we de vaste ofset waardes die we daarna kunnen gebruiken
    	BMM350_Calibrate(BMM350_Data.x, BMM350_Data.y, BMM350_Data.z, BMM350_Data.x_offset, BMM350_Data.y_offset, BMM350_Data.z_offset);
    	printf("BMM350 Data: \n");
    	printf("BMM350 Raw Data: x = %d, Y = %d, Z = %d \n\n", BMM350_Data.x, BMM350_Data.y, BMM350_Data.z);

    	// enkel de laatste offset meting is belangerijk want dan heb je de uiterste bereikt
    	printf("BMM350 offsets Data: x = %d, Y = %d, Z = %d \n\n\n\n", BMM350_Data.x_offset, BMM350_Data.y_offset, BMM350_Data.z_offset);

    	g_hoek = hoek;
    	return;
    }
    if (GPIO_Pin == GPIO_PIN_13) //INT van BMP
    {
    	float druk = BMP384_ReadData();
    	float hoogte = BMP384_CalculateAltitude(druk);

    	printf("BMP384 Data: \n");
    	printf("BMP druk = %f, hoogte = %f", druk, hoogte);
    	g_druk = druk;
    	g_hoogte = hoogte;
    	return;
    }
*/
	if (GPIO_Pin == GPIO_PIN_13)	//INT van BMP
    	{
			g_new_pressure_data = 1;
    		//return;
    	}
}
/* USER CODE END 4 */

 /* MPU Configuration */

void MPU_Config(void)
{
  MPU_Region_InitTypeDef MPU_InitStruct = {0};

  /* Disables the MPU */
  HAL_MPU_Disable();

  /** Initializes and configures the Region and the memory to be protected
  */
  MPU_InitStruct.Enable = MPU_REGION_ENABLE;
  MPU_InitStruct.Number = MPU_REGION_NUMBER0;
  MPU_InitStruct.BaseAddress = 0x0;
  MPU_InitStruct.Size = MPU_REGION_SIZE_4GB;
  MPU_InitStruct.SubRegionDisable = 0x87;
  MPU_InitStruct.TypeExtField = MPU_TEX_LEVEL0;
  MPU_InitStruct.AccessPermission = MPU_REGION_NO_ACCESS;
  MPU_InitStruct.DisableExec = MPU_INSTRUCTION_ACCESS_DISABLE;
  MPU_InitStruct.IsShareable = MPU_ACCESS_SHAREABLE;
  MPU_InitStruct.IsCacheable = MPU_ACCESS_NOT_CACHEABLE;
  MPU_InitStruct.IsBufferable = MPU_ACCESS_NOT_BUFFERABLE;

  HAL_MPU_ConfigRegion(&MPU_InitStruct);
  /* Enables the MPU */
  HAL_MPU_Enable(MPU_PRIVILEGED_DEFAULT);

}

/**
  * @brief  This function is executed in case of error occurrence.
  * @retval None
  */
void Error_Handler(void)
{
  /* USER CODE BEGIN Error_Handler_Debug */
  /* User can add his own implementation to report the HAL error return state */
  __disable_irq();
  while (1)
  {
  }
  /* USER CODE END Error_Handler_Debug */
}
#ifdef USE_FULL_ASSERT
/**
  * @brief  Reports the name of the source file and the source line number
  *         where the assert_param error has occurred.
  * @param  file: pointer to the source file name
  * @param  line: assert_param error line source number
  * @retval None
  */
void assert_failed(uint8_t *file, uint32_t line)
{
  /* USER CODE BEGIN 6 */
  /* User can add his own implementation to report the file name and line number,
     ex: printf("Wrong parameters value: file %s on line %d\r\n", file, line) */
  /* USER CODE END 6 */
}
#endif /* USE_FULL_ASSERT */
