TijmenDC1/PE2-herexamen/code/BMM350v2/Core/Inc/mc_stm_types.h

/**
  ******************************************************************************
  * @file    mc_stm_types.h
  * @author  Motor Control SDK Team, ST Microelectronics
  * @brief   Includes HAL/LL headers relevant to the current configuration.
  ******************************************************************************
  * @attention
  *
  * <h2><center>&copy; Copyright (c) 2025 STMicroelectronics.
  * All rights reserved.</center></h2>
  *
  * This software component is licensed by ST under Ultimate Liberty license
  * SLA0044, the "License"; You may not use this file except in compliance with
  * the License. You may obtain a copy of the License at:
  *                             www.st.com/SLA0044
  *
  ******************************************************************************
  */
#ifndef MC_STM_TYPES_H
#define MC_STM_TYPES_H

#ifdef FULL_MISRA_C_COMPLIANCY
#define FULL_MISRA_C_COMPLIANCY_ENC_SPD_POS
#define FULL_MISRA_C_COMPLIANCY_FWD_FDB
#define FULL_MISRA_C_COMPLIANCY_FLUX_WEAK
#define FULL_MISRA_C_COMPLIANCY_MAX_TOR
#define FULL_MISRA_C_COMPLIANCY_MC_MATH
#define FULL_MISRA_C_COMPLIANCY_NTC_TEMP
#define FULL_MISRA_C_COMPLIANCY_PID_REGULATOR
#define FULL_MISRA_C_COMPLIANCY_PFC
#define FULL_MISRA_C_COMPLIANCY_PWM_CURR
#define FULL_MISRA_C_COMPLIANCY_PW_CURR_FDB_OVM
#define FULL_MISRA_C_COMPLIANCY_SPD_TORQ_CTRL
#define FULL_MISRA_C_COMPLIANCY_STO_CORDIC
#define FULL_MISRA_C_COMPLIANCY_STO_PLL
#define FULL_MISRA_C_COMPLIANCY_VIRT_SPD_SENS
#endif

#ifdef NULL_PTR_CHECK
#define NULL_PTR_CHECK_ASP
#define NULL_PTR_CHECK_BADC
#define NULL_PTR_CHECK_BUS_VOLT
#define NULL_PTR_CHECK_CRC_LIM
#define NULL_PTR_CHECK_DAC_UI
#define NULL_PTR_CHECK_DIG_OUT
#define NULL_PTR_CHECK_ENC_ALI_CTRL
#define NULL_PTR_CHECK_ENC_SPD_POS_FDB
#define NULL_PTR_CHECK_FEED_FWD_CTRL
#define NULL_PTR_CHECK_FLUX_WEAK
#define NULL_PTR_CHECK_HALL_SPD_POS_FDB
#define NULL_PTR_CHECK_IPD_6S
#define NULL_PTR_CHECK_MAX_TRQ_PER_AMP
#define NULL_PTR_CHECK_MCP
#define NULL_PTR_CHECK_MCPA
#define NULL_PTR_CHECK_MC_INT
#define NULL_PTR_CHECK_MC_PERF
#define NULL_PTR_CHECK_MOT_POW_MES
#define NULL_PTR_CHECK_NTC_TEMP_SENS
#define NULL_PTR_CHECK_OPEN_LOOP
#define NULL_PTR_CHECK_PID_REG
#define NULL_PTR_CHECK_POT
#define NULL_PTR_CHECK_POW_COM
#define NULL_PTR_CHECK_PQD_MOT_POW_MEAS
#define NULL_PTR_CHECK_PWR_CUR_FDB
#define NULL_PTR_CHECK_PWM_CUR_FDB_OVM
#define NULL_PTR_CHECK_PWM_SIXSTEP
#define NULL_PTR_CHECK_RDIV_BUS_VLT_SNS
#define NULL_PTR_CHECK_REG_CON_MNG
#define NULL_PTR_CHECK_REG_INT
#define NULL_PTR_CHECK_REV_UP_CTL
#define NULL_PTR_CHECK_REV_UP_CTL_6STEP
#define NULL_PTR_CHECK_RMP_EXT_MNG
#define NULL_PTR_CHECK_R1_PS_PWR_CUR_FDB
#define NULL_PTR_CHECK_R3_2_PWM_CURR_FDB
#define NULL_PTR_CHECK_SDC
#define NULL_PTR_CHECK_SPD_POS_FBK
#define NULL_PTR_CHECK_SPD_POT
#define NULL_PTR_CHECK_SPD_REG_POT
#define NULL_PTR_CHECK_SPD_TRQ_CTL
#define NULL_PTR_CHECK_STL_MNG
#define NULL_PTR_CHECK_STO_COR_SPD_POS_FDB
#define NULL_PTR_CHECK_STO_PLL_SPD_POS_FDB
#define NULL_PTR_CHECK_USA_ASP_DRV
#define NULL_PTR_CHECK_VIR_SPD_SEN
#endif

#ifndef USE_FULL_LL_DRIVER
#define USE_FULL_LL_DRIVER
#endif

  #include "stm32g0xx_ll_bus.h"
  #include "stm32g0xx_ll_rcc.h"
  #include "stm32g0xx_ll_system.h"
  #include "stm32g0xx_ll_adc.h"
  #include "stm32g0xx_ll_tim.h"
  #include "stm32g0xx_ll_gpio.h"
  #include "stm32g0xx_ll_usart.h"
  #include "stm32g0xx_ll_dac.h"
  #include "stm32g0xx_ll_dma.h"
  #include "stm32g0xx_ll_comp.h"
  #include "stm32g0xx_ll_spi.h"
  #include "stm32g0xx_ll_cortex.h"

/* Make this define visible for all projects */
#define NBR_OF_MOTORS             1

__STATIC_INLINE void LL_DMA_ClearFlag_TC(DMA_TypeDef *DMAx, uint32_t Channel)
{
  if (NULL == DMAx)
  {
    /* Nothing to do */
  }
  else
  {
    /* Clear TC bits with bits position depending on parameter "Channel" */
    WRITE_REG (DMAx->IFCR, DMA_IFCR_CTCIF1 << ((Channel-LL_DMA_CHANNEL_1)<<2));
  }
}

//cstat !MISRAC2012-Rule-8.13
__STATIC_INLINE uint32_t LL_DMA_IsActiveFlag_TC(DMA_TypeDef *DMAx, uint32_t Channel)
{
  return ((NULL == DMAx) ? 0U : ((READ_BIT(DMAx->ISR,
          (DMA_ISR_TCIF1 << ((Channel-LL_DMA_CHANNEL_1)<<2))) == (DMA_ISR_TCIF1 << ((Channel-LL_DMA_CHANNEL_1)<<2))) ?
          1UL : 0UL));
}
//cstat !MISRAC2012-Rule-8.13
__STATIC_INLINE void LL_DMA_ClearFlag_HT(DMA_TypeDef *DMAx, uint32_t Channel)
{
  if (NULL == DMAx)
  {
    /* Nothing to do */
  }
  else
  {
    /* Clear HT bits with bits position depending on parameter "Channel" */
    WRITE_REG (DMAx->IFCR, DMA_IFCR_CHTIF1 << ((Channel-LL_DMA_CHANNEL_1)<<2));
  }
}
//cstat !MISRAC2012-Rule-8.13
__STATIC_INLINE uint32_t LL_DMA_IsActiveFlag_HT(DMA_TypeDef *DMAx, uint32_t Channel)
{
 return ((NULL == DMAx) ? 0U : ((READ_BIT(DMAx->ISR,
         (DMA_ISR_HTIF1 << ((Channel-LL_DMA_CHANNEL_1)<<2))) == (DMA_ISR_HTIF1 << ((Channel-LL_DMA_CHANNEL_1)<<2))) ?
         1UL : 0UL));
}

/*
* Get ADC group regular conversion data, range fit for
*        ADC resolution 12 bits Left Aligned.
* param  ADCx ADC instance
* retval Value between Min_Data=0x0000 and Max_Data=0xFFF0
*/
__STATIC_INLINE uint16_t LL_ADC_REG_ReadConversionData12L(const ADC_TypeDef *ADCx)
{
  return (uint16_t)(READ_REG(ADCx->DR) & 0x0000FFF0UL);
}

#define CIRCLE_LIMITATION_SQRT_M0

/**
 * @name Predefined Speed Units
 *
 * Each of the following symbols defines a rotation speed unit that can be used by the
 * functions of the API for their speed parameter. Each Unit is defined by expressing
 * the value of 1 Hz in this unit.
 *
 * These symbols can be used to set the #SPEED_UNIT macro which defines the rotation speed
 * unit used by the functions of the API.
 *
 * @anchor SpeedUnit
 */
/** @{ */
/** Revolutions Per Minute: 1 Hz is 60 RPM */
#define U_RPM 60
/** Tenth of Hertz: 1 Hz is 10 01Hz */
#define U_01HZ 10
/* Hundreth of Hertz: 1 Hz is 100 001Hz */
/* #define _001HZ 100 */
/** @} */

/* USER CODE BEGIN DEFINITIONS */
/* Definitions placed here will not be erased by code generation */
/**
 * @brief Rotation speed unit used at the interface with the application
 *
 * This symbols defines the value of 1 Hertz in the unit used by the functions of the API for
 * their speed parameters.
 *
 * For instance, if the chosen unit is the RPM, SPEED_UNIT is defined to 60, since 1 Hz is 60 RPM.
 * The default unit is #U_01HZ, set on the initial generation of the project by the Workbench.
 * As this symbol is defined in a User Section, custom values set by users persist across project
 * regeneration.
 *
 * PID parameters computed by the Motor Control Workbench for speed regulation are
 * suited for a speed in 01Hz. The motor control subsystem internally scales them to adapt to the
 * actual speed unit.
 *
 * This symbol should not be set to a literal numeric value. Rather, it should be set to one
 * of the symbols predefined for that purpose such as #U_RPM, #U_01HZ,... See @ref SpeedUnit for
 * more details.
 *
 * Refer to the documentation of the @ref MCIAPI for the functions that use this unit.
 *
 * @{
 */
#define SPEED_UNIT U_01HZ

/* USER CODE END DEFINITIONS */
/*!< Convenient macro to convert user friendly RPM into SpeedUnit used by MC API */
#define RPM_2_SPEED_UNIT(rpm)   ((int16_t)(((rpm)*SPEED_UNIT)/U_RPM))
/*!< Convenient macro to convert SpeedUnit used by MC API into user friendly RPM */
#define SPEED_UNIT_2_RPM(speed)   ((int16_t)(((speed)*U_RPM)/SPEED_UNIT))
/**
* @}
*/

#endif /* MC_STM_TYPES_H */
/******************* (C) COPYRIGHT 2025 STMicroelectronics *****END OF FILE****/
