TijmenDC1/PE2-herexamen/code/extra/test6step/Inc/parameters_conversion_g0xx.h

/**
  ******************************************************************************
  * @file    parameters_conversion_g0xx.h
  * @author  Motor Control SDK Team, ST Microelectronics
  * @brief   This file contains the definitions needed to convert MC SDK parameters
  *          so as to target the STM32G0 Family.
  *
  ******************************************************************************
  * @attention
  *
  * <h2><center>&copy; Copyright (c) 2025 STMicroelectronics.
  * All rights reserved.</center></h2>
  *
  * This software component is licensed by ST under Ultimate Liberty license
  * SLA0044, the "License"; You may not use this file except in compliance with
  * the License. You may obtain a copy of the License at:
  *                             www.st.com/SLA0044
  *
  ******************************************************************************
  */

/* Define to prevent recursive inclusion -------------------------------------*/
#ifndef __PARAMETERS_CONVERSION_G0XX_H
#define __PARAMETERS_CONVERSION_G0XX_H

/************************* CPU & ADC PERIPHERAL CLOCK CONFIG ******************/
#define SYSCLK_FREQ                      64000000uL
#define TIM_CLOCK_DIVIDER                1
#define ADV_TIM_CLK_MHz                  128 /* Actual TIM clk including Timer clock divider*/
#define ADC_CLK_MHz                      32 /* Maximum ADC Clock Frequency expressed in MHz */
#define HALL_TIM_CLK                     64000000uL
#define ADC1_2                           ADC1

/*************************  IRQ Handler Mapping  *********************/
#define TIMx_BRK_M1_IRQHandler        TIM1_BRK_UP_TRG_COM_IRQHandler
#if defined(COMP1)
  #define BEMF_READING_IRQHandler             ADC1_COMP_IRQHandler
#else
  #define BEMF_READING_IRQHandler             ADC1_IRQHandler
#endif /* COMP1 */
#define PERIOD_COMM_IRQHandler           TIM2_IRQHandler

/*************************  ADC Physical characteristics  ************/
#define ADC_TRIG_CONV_LATENCY_CYCLES     3
#define ADC_SAR_CYCLES                   12.5
#define M1_VBUS_SW_FILTER_BW_FACTOR      10u

#endif /*__PARAMETERS_CONVERSION_G0XX_H*/

/******************* (C) COPYRIGHT 2025 STMicroelectronics *****END OF FILE****/
