TijmenDC1/PE2-herexamen/code/extra/test6step/Src/sync_registers.c

/**
  ******************************************************************************
  * @file    sync_registers.c
  * @author  Motor Control SDK Team, ST Microelectronics
  * @brief   This file provides firmware functions that implement the register
  * access for the synchronous part of the MCP protocol.
  *
  *
  ******************************************************************************
  * @attention
  *
  * <h2><center>&copy; Copyright (c) 2025 STMicroelectronics.
  * All rights reserved.</center></h2>
  *
  * This software component is licensed by ST under Ultimate Liberty license
  * SLA0044, the "License"; You may not use this file except in compliance with
  * the License. You may obtain a copy of the License at:
  *                             www.st.com/SLA0044
  *
  ******************************************************************************
  */

#include "mc_type.h"
#include "string.h"
#include "register_interface.h"
#include "mc_config.h"
#include "mcp.h"
#include "mcp_config.h"
#include "mc_configuration_registers.h"

uint8_t RI_SetRegisterGlobal(uint16_t regID, uint8_t typeID, uint8_t *data, uint16_t *size, int16_t dataAvailable)
{
  uint8_t retVal = MCP_CMD_OK;
  switch(typeID)
  {
    case TYPE_DATA_8BIT:
    {
      switch (regID)
      {
        case MC_REG_STATUS:
        {
          retVal = MCP_ERROR_RO_REG;
          break;
        }

        default:
        {
          retVal = MCP_ERROR_UNKNOWN_REG;
          break;
        }
      }
      *size = 1;
      break;
    }

    case TYPE_DATA_16BIT:
    {
      switch (regID)
      {

        case MC_REG_BUS_VOLTAGE:
        case MC_REG_HEATS_TEMP:
        case MC_REG_MOTOR_POWER:
        {
          retVal = MCP_ERROR_RO_REG;
          break;
        }

        case MC_REG_DAC_USER1:
        case MC_REG_DAC_USER2:
        break;

        default:
        {
          retVal = MCP_ERROR_UNKNOWN_REG;
          break;
        }
      }
      *size = 2;
      break;
    }

    case TYPE_DATA_32BIT:
    {

      switch (regID)
      {
        case MC_REG_FAULTS_FLAGS:
        {
          retVal = MCP_ERROR_RO_REG;
          break;
        }

        default:
        {
          retVal = MCP_ERROR_UNKNOWN_REG;
          break;
        }
      }
      *size = 4;
      break;
    }

    case TYPE_DATA_STRING:
    {
      const char_t *charData = (const char_t *)data;
      char_t *dummy = (char_t *)data;
      retVal = MCP_ERROR_RO_REG;
      /* Used to compute String length stored in RXBUFF even if Reg does not exist */
      /* It allows to jump to the next command in the buffer */
      (void)RI_MovString(charData, dummy, size, dataAvailable);
      break;
    }

    case TYPE_DATA_RAW:
    {
      uint16_t rawSize = *(uint16_t *)data; //cstat !MISRAC2012-Rule-11.3
      /* The size consumed by the structure is the structure size + 2 bytes used to store the size */
      *size = rawSize + 2U;
      uint8_t *rawData = data; /* rawData points to the first data (after size extraction) */
      rawData++;
      rawData++;

      if (*size > (uint16_t)dataAvailable)
      {
        /* The decoded size of the raw structure can not match with transmitted buffer, error in buffer
           construction */
        *size = 0;
        retVal = MCP_ERROR_BAD_RAW_FORMAT; /* This error stop the parsing of the CMD buffer */
      }
      else
      {
        switch (regID)
        {
          case MC_REG_APPLICATION_CONFIG:
          case MC_REG_MOTOR_CONFIG:
          case MC_REG_GLOBAL_CONFIG:
          case MC_REG_FOCFW_CONFIG:
          {
            retVal = MCP_ERROR_RO_REG;
            break;
          }

          default:
          {
            retVal = MCP_ERROR_UNKNOWN_REG;
            break;
          }
        }

      }
      break;
    }

    default:
    {
      retVal = MCP_ERROR_BAD_DATA_TYPE;
      *size =0; /* From this point we are not able anymore to decode the RX buffer */
      break;
    }
  }
  return (retVal);
}

uint8_t RI_SetRegisterMotor1(uint16_t regID, uint8_t typeID, uint8_t *data, uint16_t *size, int16_t dataAvailable)
{
  uint8_t retVal = MCP_CMD_OK;
  uint8_t motorID=0;
  MCI_Handle_t *pMCIN = &Mci[motorID];

  switch(typeID)
  {
    case TYPE_DATA_8BIT:
    {
      switch (regID)
      {
        case MC_REG_STATUS:
          {
            retVal = MCP_ERROR_RO_REG;
            break;
          }
        case MC_REG_RUC_STAGE_NBR:
        {
          retVal = MCP_ERROR_RO_REG;
          break;
        }

        case MC_REG_LOWSIDE_MODULATION:
        {
          uint8_t regdataU8 = *(uint8_t *)data;
          PWMC_SetLSModConfig(&PWM_Handle_M1, regdataU8);
          break;
        }

        case MC_REG_QUASI_SYNCH:
        {
          uint8_t regdata8 = *data;
          PWMC_SetQuasiSynchState(&PWM_Handle_M1, regdata8);
          break;
        }

        default:
        {
          retVal = MCP_ERROR_UNKNOWN_REG;
          break;
        }
      }
      *size = 1;
      break;
    }

    case TYPE_DATA_16BIT:
    {
      uint16_t regdata16 = *(uint16_t *)data; //cstat !MISRAC2012-Rule-11.3
      switch (regID)
      {

        case MC_REG_SPEED_KP:
        {
          PID_SetKP(&PIDSpeedHandle_M1, (int16_t)regdata16);
          break;
        }

        case MC_REG_SPEED_KI:
        {
          PID_SetKI(&PIDSpeedHandle_M1, (int16_t)regdata16);
          break;
        }

        case MC_REG_SPEED_KD:
        {
          PID_SetKD(&PIDSpeedHandle_M1, (int16_t)regdata16);
          break;
        }

        case MC_REG_BUS_VOLTAGE:
        case MC_REG_HEATS_TEMP:
        case MC_REG_MOTOR_POWER:
        {
          retVal = MCP_ERROR_RO_REG;
          break;
        }

        case MC_REG_DAC_USER1:
        case MC_REG_DAC_USER2:
          break;

        case MC_REG_SPEED_KP_DIV:
        {
          PID_SetKPDivisorPOW2(&PIDSpeedHandle_M1, regdata16);
          break;
        }

        case MC_REG_SPEED_KI_DIV:
        {
          PID_SetKIDivisorPOW2(&PIDSpeedHandle_M1, regdata16);
          break;
        }

        case MC_REG_SPEED_KD_DIV:
        {
          PID_SetKDDivisorPOW2(&PIDSpeedHandle_M1, regdata16);
          break;
        }

        case MC_REG_PULSE_VALUE:
        {
          retVal = MCP_ERROR_RO_REG;
          break;
        }

        default:
        {
          retVal = MCP_ERROR_UNKNOWN_REG;
          break;
        }
      }
      *size = 2;
      break;
    }

    case TYPE_DATA_32BIT:
    {
      uint32_t regdata32 = (((uint32_t)(*(uint16_t *)&data[2])) << 16) | *(uint16_t *)data;

      switch (regID)
      {
        case MC_REG_FAULTS_FLAGS:
        case MC_REG_SPEED_MEAS:
        {
          retVal = MCP_ERROR_RO_REG;
          break;
        }

        case MC_REG_SPEED_REF:
        {
          MCI_ExecSpeedRamp(pMCIN,((((int16_t)regdata32) * ((int16_t)SPEED_UNIT)) / (int16_t)U_RPM), 0);
          break;
        }

        default:
        {
          retVal = MCP_ERROR_UNKNOWN_REG;
          break;
        }
      }
      *size = 4;
      break;
    }

    case TYPE_DATA_STRING:
    {
      const char_t *charData = (const char_t *)data;
      char_t *dummy = (char_t *)data;
      retVal = MCP_ERROR_RO_REG;
      /* Used to compute String length stored in RXBUFF even if Reg does not exist */
      /* It allows to jump to the next command in the buffer */
      (void)RI_MovString(charData, dummy, size, dataAvailable);
      break;
    }

    case TYPE_DATA_RAW:
    {
      uint16_t rawSize = *(uint16_t *)data; //cstat !MISRAC2012-Rule-11.3
      /* The size consumed by the structure is the structure size + 2 bytes used to store the size */
      *size = rawSize + 2U;
      uint8_t *rawData = data; /* rawData points to the first data (after size extraction) */
      rawData++;
      rawData++;

      if (*size > (uint16_t)dataAvailable)
      {
        /* The decoded size of the raw structure can not match with transmitted buffer, error in buffer
           construction */
        *size = 0;
        retVal = MCP_ERROR_BAD_RAW_FORMAT; /* This error stop the parsing of the CMD buffer */
      }
      else
      {
        switch (regID)
        {
          case MC_REG_APPLICATION_CONFIG:
          case MC_REG_MOTOR_CONFIG:
          case MC_REG_GLOBAL_CONFIG:
          case MC_REG_FOCFW_CONFIG:
          {
            retVal = MCP_ERROR_RO_REG;
            break;
          }

          case MC_REG_SPEED_RAMP:
          {
            int32_t rpm;
            uint16_t duration;

            /* 32 bits access are splited into 2x16 bits access */
            rpm = (((int32_t)(*(int16_t *)&rawData[2])) << 16) | *(uint16_t *)rawData; //cstat !MISRAC2012-Rule-11.3
            duration = *(uint16_t *)&rawData[4]; //cstat !MISRAC2012-Rule-11.3
            MCI_ExecSpeedRamp(pMCIN, (int16_t)((rpm * SPEED_UNIT) / U_RPM), duration);
            break;
          }

          case MC_REG_REVUP_DATA:
          {
            int32_t rpm;
            RevUpCtrl_6S_PhaseParams_t revUpPhase;
            uint8_t i;
            uint8_t nbrOfPhase = (((uint8_t)rawSize) / 8U);

            if (((0U != ((rawSize) % 8U))) || ((nbrOfPhase > RUC_MAX_PHASE_NUMBER) != 0))
            {
              retVal = MCP_ERROR_BAD_RAW_FORMAT;
            }
            else
            {
              for (i = 0; i <nbrOfPhase; i++)
              {
              /* &rawData is guarantee to be 16 bits aligned, so 32 bits access are to be splitted */
              //cstat !MISRAC2012-Rule-11.3
              rpm = ((int32_t)(*(int16_t *)&rawData[2+i*8]))<<16 | *(uint16_t *)&rawData[i*8];
              revUpPhase.hFinalMecSpeedUnit = (((int16_t)rpm) * ((int16_t)SPEED_UNIT)) / ((int16_t)U_RPM);
              revUpPhase.hFinalPulse = *((int16_t *) &rawData[4U + (i * 8U)]); //cstat !MISRAC2012-Rule-11.3
              revUpPhase.hDurationms  = *((uint16_t *) &rawData[6U +(i * 8U)]); //cstat !MISRAC2012-Rule-11.3
              (void)RUC_6S_SetPhase(&RevUpControlM1, i, &revUpPhase);
              }
            }
            break;
          }

          case MC_REG_BEMF_ADC_CONF:
          {
            Bemf_Sensing_Params BemfAdcConfig;
            Bemf_Demag_Params bemfAdcDemagConfig;
            Bemf_RegInterface_Param bemfRegIntParam;
            uint16_t ConvertedData;

            BemfAdcConfig.AdcThresholdHighPerc = *(uint16_t *)rawData; //cstat !MISRAC2012-Rule-11.3

            BemfAdcConfig.AdcThresholdPwmPerc = *(uint16_t *)&rawData[2]; //cstat !MISRAC2012-Rule-11.3

            BemfAdcConfig.AdcThresholdLowPerc = *(uint16_t *)&rawData[4]; //cstat !MISRAC2012-Rule-11.3

            ConvertedData = *(uint16_t *)&rawData[6]; //cstat !MISRAC2012-Rule-11.3
            BemfAdcConfig.SamplingPointOff = (uint16_t) ((PWM_PERIOD_CYCLES * ConvertedData) / 100);

            ConvertedData = *(uint16_t *)&rawData[8]; //cstat !MISRAC2012-Rule-11.3
            BemfAdcConfig.SamplingPointOn = (uint16_t) ((PWM_PERIOD_CYCLES * ConvertedData) / 100);

            ConvertedData = *(uint16_t *)&rawData[10]; //cstat !MISRAC2012-Rule-11.3
            bemfRegIntParam.ZcRising2CommDelay = (uint16_t) ((ConvertedData * 512) / 60);

            ConvertedData = *(uint16_t *)&rawData[12]; //cstat !MISRAC2012-Rule-11.3
            bemfRegIntParam.ZcFalling2CommDelay = (uint16_t) ((ConvertedData * 512) / 60);

            bemfAdcDemagConfig.DemagMinimumThreshold = *(uint16_t *)&rawData[14]; //cstat !MISRAC2012-Rule-11.3

            ConvertedData = *(uint16_t *)&rawData[16]; //cstat !MISRAC2012-Rule-11.3
            bemfAdcDemagConfig.DemagMinimumSpeedUnit = (uint16_t) ((ConvertedData * SPEED_UNIT) / U_RPM); //cstat !MISRAC2012-Rule-11.3

            ConvertedData = *(uint16_t *)&rawData[18]; //cstat !MISRAC2012-Rule-11.3
            bemfRegIntParam.OnSensingEnThres = (uint16_t) ((PWM_PERIOD_CYCLES * ConvertedData) / 100);

            ConvertedData = *(uint16_t *)&rawData[20]; //cstat !MISRAC2012-Rule-11.3
            bemfRegIntParam.OnSensingDisThres = (uint16_t) ((PWM_PERIOD_CYCLES * ConvertedData) / 100);

            BemfAdcConfig.AWDfiltering = *(uint16_t *)&rawData[22]; //cstat !MISRAC2012-Rule-11.3

            bemfRegIntParam.ComputationDelay = *(uint16_t *)&rawData[24];

            (void)BADC_SetBemfSensorlessParam(&Bemf_ADC_M1, &BemfAdcConfig, &bemfAdcDemagConfig, &bemfRegIntParam);

            break;
          }

          default:
          {
            retVal = MCP_ERROR_UNKNOWN_REG;
            break;
          }
        }
      }
      break;
    }

    default:
    {
      retVal = MCP_ERROR_BAD_DATA_TYPE;
      *size =0; /* From this point we are not able anymore to decode the RX buffer */
      break;
    }
  }
  return (retVal);
}

uint8_t RI_GetRegisterGlobal(uint16_t regID,uint8_t typeID,uint8_t * data,uint16_t *size,int16_t freeSpace){
    uint8_t retVal = MCP_CMD_OK;
    switch (typeID)
    {
      case TYPE_DATA_8BIT:
      {
        if (freeSpace > 0)
        {
          switch (regID)
          {
            default:
            {
              retVal = MCP_ERROR_UNKNOWN_REG;
              break;
            }
          }
          *size = 1;
        }
        else
        {
          retVal = MCP_ERROR_NO_TXSYNC_SPACE;
        }
        break;
      }

      case TYPE_DATA_16BIT:
      {
        if (freeSpace >= 2)
        {
          switch (regID)
          {
            case MC_REG_DAC_USER1:
            case MC_REG_DAC_USER2:
              break;

            default:
            {
              retVal = MCP_ERROR_UNKNOWN_REG;
              break;
            }
          }
          *size = 2;
        }
        else
        {
          retVal = MCP_ERROR_NO_TXSYNC_SPACE;
        }
        break;
      }

      case TYPE_DATA_32BIT:
      {
        if (freeSpace >= 4)
        {
          switch (regID)
          {

            default:
            {
              retVal = MCP_ERROR_UNKNOWN_REG;
              break;
            }
          }
          *size = 4;
        }
        else
        {
          retVal = MCP_ERROR_NO_TXSYNC_SPACE;
        }
        break;
      }

      case TYPE_DATA_STRING:
      {
        char_t *charData = (char_t *)data;
        switch (regID)
        {
          case MC_REG_FW_NAME:
            retVal = RI_MovString (FIRMWARE_NAME ,charData, size, freeSpace);
            break;

          case MC_REG_CTRL_STAGE_NAME:
          {
            retVal = RI_MovString (CTL_BOARD ,charData, size, freeSpace);
            break;
          }
          default:
          {

            retVal = MCP_ERROR_UNKNOWN_REG;
            *size= 0 ; /* */

            break;
          }
        }
        break;

      }
      case TYPE_DATA_RAW:
      {
        /* First 2 bytes of the answer is reserved to the size */
        uint16_t *rawSize = (uint16_t *)data; //cstat !MISRAC2012-Rule-11.3
        uint8_t * rawData = data;
        rawData++;
        rawData++;

        switch (regID)
        {
          case MC_REG_GLOBAL_CONFIG:
          {
            *rawSize = (uint16_t)sizeof(GlobalConfig_reg_t);
            if (((*rawSize) + 2U) > (uint16_t)freeSpace)
            {
              retVal = MCP_ERROR_NO_TXSYNC_SPACE;
            }
            else
            {
              (void)memcpy(rawData, &globalConfig_reg, sizeof(GlobalConfig_reg_t));
            }
            break;
          }
          case MC_REG_ASYNC_UARTA:
          case MC_REG_ASYNC_UARTB:
          case MC_REG_ASYNC_STLNK:
          default:
          {
            retVal = MCP_ERROR_UNKNOWN_REG;
            break;
          }
        }

        /* Size of the answer is size of the data + 2 bytes containing data size */
        *size = (*rawSize) + 2U;
        break;
      }

      default:
      {
        retVal = MCP_ERROR_BAD_DATA_TYPE;
        break;
      }
    }
  return (retVal);
}

  uint8_t RI_GetRegisterMotor1(uint16_t regID,uint8_t typeID,uint8_t * data,uint16_t *size,int16_t freeSpace) {
    uint8_t retVal = MCP_CMD_OK;
    uint8_t motorID=0;
    MCI_Handle_t *pMCIN = &Mci[motorID];
    BusVoltageSensor_Handle_t* BusVoltageSensor= &BusVoltageSensor_M1._Super;
    switch (typeID)
    {
      case TYPE_DATA_8BIT:
      {
        if (freeSpace > 0)
        {
          switch (regID)
          {
            case MC_REG_STATUS:
            {
              *data = (uint8_t)MCI_GetSTMState(pMCIN);
              break;
            }

            case MC_REG_CONTROL_MODE:
            {
              *data = (uint8_t)MCI_GetControlMode(pMCIN);
              break;
            }

            case MC_REG_RUC_STAGE_NBR:
            {
              *data = (uint8_t)RUC_6S_GetNumberOfPhases(&RevUpControlM1);
              break;
            }

            case MC_REG_LOWSIDE_MODULATION:
            {
              *data = PWMC_GetLSModConfig(&PWM_Handle_M1);
              break;
            }

            case MC_REG_QUASI_SYNCH:
            {
              *data = (uint8_t)PWMC_GetQuasiSynchState(&PWM_Handle_M1);
              break;
            }

            default:
            {
              retVal = MCP_ERROR_UNKNOWN_REG;
              break;
            }
          }
          *size = 1;
        }
        else
        {
          retVal = MCP_ERROR_NO_TXSYNC_SPACE;
        }
        break;
      }

      case TYPE_DATA_16BIT:
      {
        uint16_t *regdataU16 = (uint16_t *)data; //cstat !MISRAC2012-Rule-11.3
        int16_t *regdata16 = (int16_t *) data; //cstat !MISRAC2012-Rule-11.3

        if (freeSpace >= 2)
        {
          switch (regID)
          {

            case MC_REG_SPEED_KP:
            {
              *regdata16 = PID_GetKP(&PIDSpeedHandle_M1);
              break;
            }

            case MC_REG_SPEED_KI:
            {
              *regdata16 = PID_GetKI(&PIDSpeedHandle_M1);
              break;
            }

            case MC_REG_SPEED_KD:
            {
              *regdata16 = PID_GetKD(&PIDSpeedHandle_M1);
              break;
            }

            case MC_REG_BUS_VOLTAGE:
            {
              *regdataU16 = VBS_GetAvBusVoltage_V(BusVoltageSensor);
              break;
            }

            case MC_REG_HEATS_TEMP:
            {
              *regdata16 = NTC_GetAvTemp_C(&TempSensor_M1);
              break;
            }

            case MC_REG_DAC_USER1:
            case MC_REG_DAC_USER2:
              break;

            case MC_REG_SPEED_KP_DIV:
            {
              *regdataU16 = (uint16_t)PID_GetKPDivisorPOW2(&PIDSpeedHandle_M1);
              break;
            }

            case MC_REG_SPEED_KI_DIV:
            {
              *regdataU16 = (uint16_t)PID_GetKIDivisorPOW2(&PIDSpeedHandle_M1);
              break;
            }

            case MC_REG_SPEED_KD_DIV:
            {
              *regdataU16 = PID_GetKDDivisorPOW2(&PIDSpeedHandle_M1);
              break;
            }

            case MC_REG_PULSE_VALUE:
            {
              *regdataU16 = MCI_GetDutyCycleRef(pMCIN);
              break;
            }

            default:
            {
              retVal = MCP_ERROR_UNKNOWN_REG;
              break;
            }
          }
          *size = 2;
        }
        else
        {
          retVal = MCP_ERROR_NO_TXSYNC_SPACE;
        }
        break;
      }

      case TYPE_DATA_32BIT:
      {
        uint32_t *regdataU32 = (uint32_t *)data; //cstat !MISRAC2012-Rule-11.3
        int32_t *regdata32 = (int32_t *)data; //cstat !MISRAC2012-Rule-11.3

        if (freeSpace >= 4)
        {
          switch (regID)
          {
            case MC_REG_FAULTS_FLAGS:
            {
              *regdataU32 = MCI_GetFaultState(pMCIN);
              break;
            }
            case MC_REG_SPEED_MEAS:
            {
              *regdata32 = (((int32_t)MCI_GetAvrgMecSpeedUnit(pMCIN) * U_RPM) / SPEED_UNIT);
              break;
            }

            case MC_REG_SPEED_REF:
            {
              *regdata32 = (((int32_t)MCI_GetMecSpeedRefUnit(pMCIN) * U_RPM) / SPEED_UNIT);
              break;
            }

            default:
            {
              retVal = MCP_ERROR_UNKNOWN_REG;
              break;
            }
          }
          *size = 4;
        }
        else
        {
          retVal = MCP_ERROR_NO_TXSYNC_SPACE;
        }
        break;
      }

      case TYPE_DATA_STRING:
      {
        char_t *charData = (char_t *)data;
        switch (regID)
        {
          case MC_REG_PWR_STAGE_NAME:
          {
            retVal = RI_MovString (PWR_BOARD_NAME[motorID], charData, size, freeSpace);
            break;
          }

          case MC_REG_MOTOR_NAME:
          {
            retVal = RI_MovString (MotorConfig_reg[motorID]->name ,charData, size, freeSpace);
            break;
          }

          default:
          {
            retVal = MCP_ERROR_UNKNOWN_REG;
            *size= 0 ; /* */
            break;
          }
        }
        break;
      }

      case TYPE_DATA_RAW:
      {
        /* First 2 bytes of the answer is reserved to the size */
        uint16_t *rawSize = (uint16_t *)data; //cstat !MISRAC2012-Rule-11.3
        uint8_t * rawData = data;
        rawData++;
        rawData++;

        switch (regID)
        {
          case MC_REG_APPLICATION_CONFIG:
          {
            *rawSize = (uint16_t)sizeof(ApplicationConfig_reg_t);
            if (((*rawSize) + 2U) > (uint16_t)freeSpace)
            {
              retVal = MCP_ERROR_NO_TXSYNC_SPACE;
            }
            else
            {
              ApplicationConfig_reg_t const *pApplicationConfig_reg = ApplicationConfig_reg[motorID];
              (void)memcpy(rawData, (const uint8_t *)pApplicationConfig_reg, sizeof(ApplicationConfig_reg_t));
            }
            break;
          }

          case MC_REG_MOTOR_CONFIG:
          {
            *rawSize = (uint16_t)sizeof(MotorConfig_reg_t);
            if (((*rawSize) + 2U) > (uint16_t)freeSpace)
            {
              retVal = MCP_ERROR_NO_TXSYNC_SPACE;
            }
            else
            {
              MotorConfig_reg_t const *pMotorConfig_reg = MotorConfig_reg[motorID];
              (void)memcpy(rawData, (const uint8_t *)pMotorConfig_reg, sizeof(MotorConfig_reg_t));
            }
            break;
          }

          case MC_REG_FOCFW_CONFIG:
          {
            *rawSize = (uint16_t)sizeof(SixStepFwConfig_reg_t);
            if (((*rawSize) + 2U) > (uint16_t)freeSpace)
            {
              retVal = MCP_ERROR_NO_TXSYNC_SPACE;
            }
            else
            {
              SixStepFwConfig_reg_t const *pSixStepConfig_reg = SixStepConfig_reg[motorID];
              (void)memcpy(rawData, (const uint8_t *)pSixStepConfig_reg, sizeof(SixStepFwConfig_reg_t));
            }
            break;
          }
          case MC_REG_SCALE_CONFIG:
          {
            *rawSize = 12;
            if ((*rawSize) +2U > (uint16_t)freeSpace)
            {
              retVal = MCP_ERROR_NO_TXSYNC_SPACE;
            }
            else
            {
              memcpy(rawData, &scaleParams_M1, sizeof(ScaleParams_t) );
            }
            break;
          }
          case MC_REG_SPEED_RAMP:
          {
            uint16_t *rpm16p = (uint16_t *)rawData; //cstat !MISRAC2012-Rule-11.3
            uint16_t *duration = (uint16_t *)&rawData[4]; //cstat !MISRAC2012-Rule-11.3
            int32_t rpm32 = ((int32_t)(MCI_GetLastRampFinalSpeed(pMCIN) * U_RPM) / (int32_t)SPEED_UNIT);
            *rpm16p = (uint16_t)rpm32;
            *(rpm16p+1) = (uint16_t)(rpm32>>16);
            *duration = MCI_GetLastRampFinalDuration(pMCIN);
            *rawSize = 6;
            break;
          }

          case MC_REG_REVUP_DATA:
          {
            int32_t rpm32;
            int16_t *rpm16p;
            uint16_t *finalPulse;
            uint16_t *durationms;
            RevUpCtrl_6S_PhaseParams_t revUpPhase;
            uint8_t i;

            *rawSize = (uint16_t)RUC_MAX_PHASE_NUMBER*8U;
            if (((*rawSize) + 2U) > (uint16_t)freeSpace)
            {
              retVal = MCP_ERROR_NO_TXSYNC_SPACE;
            }
            else
            {
              for (i = 0; i <RUC_MAX_PHASE_NUMBER; i++)
              {
                (void)RUC_6S_GetPhase( &RevUpControlM1 ,i, &revUpPhase);
                rpm32 = (((int32_t)revUpPhase.hFinalMecSpeedUnit) * U_RPM) / SPEED_UNIT; //cstat !MISRAC2012-Rule-11.3
                rpm16p = (int16_t *)&data[2U + (i * 8U)]; //cstat !MISRAC2012-Rule-11.3
                *rpm16p = (uint16_t)rpm32; /* 16 LSB access */ //cstat !MISRAC2012-Rule-11.3
                *(rpm16p+1) = ((uint16_t)(rpm32 >> 16)); /* 16 MSB access */ //cstat !MISRAC2012-Rule-11.3
                finalPulse = (uint16_t *)&data[6U + (i * 8U)]; //cstat !MISRAC2012-Rule-11.3
                *finalPulse = (uint16_t)revUpPhase.hFinalPulse; //cstat !MISRAC2012-Rule-11.3
                durationms  = (uint16_t *)&data[8U + (i * 8U)]; //cstat !MISRAC2012-Rule-11.3
                *durationms  = revUpPhase.hDurationms;
              }
            }
            break;
          }

          case MC_REG_BEMF_ADC_CONF:
          {
            Bemf_Sensing_Params bemfAdcConfig;
            Bemf_Demag_Params bemfAdcDemagConfig;
            Bemf_RegInterface_Param bemfRegIntParam;
            uint16_t *ConvertedData;

            (void)BADC_GetBemfSensorlessParam(&Bemf_ADC_M1, &bemfAdcConfig, &bemfAdcDemagConfig, &bemfRegIntParam);
            ConvertedData = (uint16_t *)rawData;  //cstat !MISRAC2012-Rule-11.3
            *ConvertedData = bemfAdcConfig.AdcThresholdHighPerc;

            ConvertedData = (uint16_t *)&rawData[2]; //cstat !MISRAC2012-Rule-11.3
            *ConvertedData = bemfAdcConfig.AdcThresholdPwmPerc;

            ConvertedData = (uint16_t *)&rawData[4]; //cstat !MISRAC2012-Rule-11.3
            *ConvertedData = bemfAdcConfig.AdcThresholdLowPerc;

            ConvertedData = (uint16_t *)&rawData[6]; //cstat !MISRAC2012-Rule-11.3
            *ConvertedData = (uint16_t)((100 * bemfAdcConfig.SamplingPointOff) / PWM_PERIOD_CYCLES) + 1U;

            ConvertedData = (uint16_t *)&rawData[8]; //cstat !MISRAC2012-Rule-11.3
            *ConvertedData = (uint16_t)((100 * bemfAdcConfig.SamplingPointOn) / PWM_PERIOD_CYCLES) + 1U;

            ConvertedData = (uint16_t *)&rawData[10]; //cstat !MISRAC2012-Rule-11.3
            *ConvertedData = ((bemfRegIntParam.ZcRising2CommDelay * 0.12) < 1) ? 1 : (uint16_t)(bemfRegIntParam.ZcRising2CommDelay * 0.12);

            ConvertedData = (uint16_t *)&rawData[12]; //cstat !MISRAC2012-Rule-11.3
            *ConvertedData = ((bemfRegIntParam.ZcFalling2CommDelay * 0.12) < 1) ? 1 : (uint16_t)(bemfRegIntParam.ZcFalling2CommDelay * 0.12);

            ConvertedData = (uint16_t *)&rawData[14]; //cstat !MISRAC2012-Rule-11.3
            *ConvertedData = bemfAdcDemagConfig.DemagMinimumThreshold;

            ConvertedData = (uint16_t *)&rawData[16]; //cstat !MISRAC2012-Rule-11.3
            *ConvertedData = (uint16_t) ((bemfAdcDemagConfig.DemagMinimumSpeedUnit * U_RPM) / SPEED_UNIT) ;

            ConvertedData = (uint16_t *)&rawData[18]; //cstat !MISRAC2012-Rule-11.3
            *ConvertedData = (uint16_t)((100 * bemfRegIntParam.OnSensingEnThres) / PWM_PERIOD_CYCLES) + 1U;

            ConvertedData = (uint16_t *)&rawData[20]; //cstat !MISRAC2012-Rule-11.3
            *ConvertedData = (uint16_t)((100 * bemfRegIntParam.OnSensingDisThres) / PWM_PERIOD_CYCLES) + 1U;

            ConvertedData = (uint16_t *)&rawData[22]; //cstat !MISRAC2012-Rule-11.3
            *ConvertedData = bemfAdcConfig.AWDfiltering;

            ConvertedData = (uint16_t *)&rawData[24]; //cstat !MISRAC2012-Rule-11.3
            *ConvertedData = bemfRegIntParam.ComputationDelay;

            *rawSize = 26;

            break;
          }

          case MC_REG_ASYNC_UARTA:
          case MC_REG_ASYNC_UARTB:
          case MC_REG_ASYNC_STLNK:
          default:
          {
            retVal = MCP_ERROR_UNKNOWN_REG;
            break;
          }
        }

        /* Size of the answer is size of the data + 2 bytes containing data size */
        *size = (*rawSize) + 2U;
        break;
      }

      default:
      {
        retVal = MCP_ERROR_BAD_DATA_TYPE;
        break;
      }
    }
    return (retVal);
  }

uint8_t RI_MovString(const char_t *srcString, char_t *destString, uint16_t *size, int16_t maxSize)
{
  uint8_t retVal = MCP_CMD_OK;
  const char_t *tempsrcString = srcString;
  char_t *tempdestString = destString;
  *size= 1U ; /* /0 is the min String size */

  while ((*tempsrcString != (char_t)0) && (*size < (uint16_t)maxSize))
  {
    *tempdestString = *tempsrcString;
    tempdestString++;
    tempsrcString++;
    *size = *size + 1U;
  }

  if (*tempsrcString != (char_t)0)
  { /* Last string char must be 0 */
    retVal = MCP_ERROR_STRING_FORMAT;
  }
  else
  {
    *tempdestString = (int8_t)0;
  }
  return (retVal);
}

/************************ (C) COPYRIGHT 2025 STMicroelectronics *****END OF FILE****/
