TijmenDC1/PE2-herexamen/code/extra/test6step/Inc/register_interface.h

/**
  ******************************************************************************
  * @file    register_interface.h
  * @author  Motor Control SDK Team, ST Microelectronics
  * @brief   This file provides firmware registers definitions used by MCP protocol
  *
  *
  ******************************************************************************
  * @attention
  *
  * <h2><center>&copy; Copyright (c) 2025 STMicroelectronics.
  * All rights reserved.</center></h2>
  *
  * This software component is licensed by ST under Ultimate Liberty license
  * SLA0044, the "License"; You may not use this file except in compliance with
  * the License. You may obtain a copy of the License at:
  *                             www.st.com/SLA0044
  *
  ******************************************************************************
  */

#ifndef REGISTER_INTERFACE_H
#define REGISTER_INTERFACE_H
#include "mc_type.h"
#include "mc_parameters.h"

/*
   MCP_ID definition :
   | Element Identifier 10 bits  |  Type  | Motor #|
   |                             |        |        |
   |15|14|13|12|11|10|09|08|07|06|05|04|03|02|01|00|

   Type definition :
   0	Reserved
   1	8-bit data
   2	16-bit data
   3	32-bit data
   4	Character string
   5	Raw Structure
   6	Reserved
   7	Reserved
*/
#define MCP_ID_SIZE                      2U /* Number of byte */
#define MCP_ID_SIZE_16B                  1U /* Number of 16bits word */
#define ELT_IDENTIFIER_POS               6U
#define TYPE_POS                         3U
#define TYPE_MASK                        0x38U
#define MOTOR_MASK                       0x7U
#define REG_MASK                         0xFFF8U

#define EXTRACT_MOTORID(dataID)          ((dataID -1U) & MOTOR_MASK)

#define TYPE_DATA_SEG_END                (0U << TYPE_POS)
#define TYPE_DATA_8BIT                   (1U << TYPE_POS)
#define TYPE_DATA_16BIT                  (2U << TYPE_POS)
#define TYPE_DATA_32BIT                  (3U << TYPE_POS)
#define TYPE_DATA_STRING                 (4U << TYPE_POS)
#define TYPE_DATA_RAW                    (5U << TYPE_POS)
#define TYPE_DATA_FLAG                   (6U << TYPE_POS)
#define TYPE_DATA_SEG_BEG                (7U << TYPE_POS)

/* TYPE_DATA_8BIT registers definition */
#define  MC_REG_STATUS                   ((1U << ELT_IDENTIFIER_POS) | TYPE_DATA_8BIT)
#define  MC_REG_CONTROL_MODE             ((2U << ELT_IDENTIFIER_POS) | TYPE_DATA_8BIT)
#define  MC_REG_RUC_STAGE_NBR            ((3U << ELT_IDENTIFIER_POS) | TYPE_DATA_8BIT)
#define  MC_REG_PFC_STATUS               ((13U << ELT_IDENTIFIER_POS) | TYPE_DATA_8BIT)
#define  MC_REG_PFC_ENABLED              ((14U << ELT_IDENTIFIER_POS) | TYPE_DATA_8BIT)
#define  MC_REG_SC_CHECK                 ((15U << ELT_IDENTIFIER_POS) | TYPE_DATA_8BIT)
#define  MC_REG_SC_STATE                 ((16U << ELT_IDENTIFIER_POS) | TYPE_DATA_8BIT)
#define  MC_REG_SC_STEPS                 ((17U << ELT_IDENTIFIER_POS) | TYPE_DATA_8BIT)
#define  MC_REG_SC_PP                    ((18U << ELT_IDENTIFIER_POS) | TYPE_DATA_8BIT)
#define  MC_REG_SC_FOC_REP_RATE          ((19U << ELT_IDENTIFIER_POS) | TYPE_DATA_8BIT)
#define  MC_REG_SC_COMPLETED             ((20U << ELT_IDENTIFIER_POS) | TYPE_DATA_8BIT)
#define  MC_REG_POSITION_CTRL_STATE      ((21U << ELT_IDENTIFIER_POS) | TYPE_DATA_8BIT)
#define  MC_REG_POSITION_ALIGN_STATE     ((22U << ELT_IDENTIFIER_POS) | TYPE_DATA_8BIT)
#define  MC_REG_HT_STATE                 ((23U << ELT_IDENTIFIER_POS) | TYPE_DATA_8BIT)
#define  MC_REG_HT_PROGRESS              ((24U << ELT_IDENTIFIER_POS) | TYPE_DATA_8BIT)
#define  MC_REG_HT_PLACEMENT             ((25U << ELT_IDENTIFIER_POS) | TYPE_DATA_8BIT)
#define  MC_REG_HT_MECH_WANTED_DIRECTION ((26U << ELT_IDENTIFIER_POS) | TYPE_DATA_8BIT)
#define  MC_REG_LOWSIDE_MODULATION       ((27U << ELT_IDENTIFIER_POS) | TYPE_DATA_8BIT)
#define  MC_REG_QUASI_SYNCH              ((28U << ELT_IDENTIFIER_POS) | TYPE_DATA_8BIT)
#define  MC_REG_PB_CHARACTERIZATION      ((29U << ELT_IDENTIFIER_POS) | TYPE_DATA_8BIT)
#define  MC_REG_OPENLOOP_DC              ((30U << ELT_IDENTIFIER_POS) | TYPE_DATA_8BIT)
#define  MC_REG_OPENLOOP_DC_FILTER       ((31U << ELT_IDENTIFIER_POS) | TYPE_DATA_8BIT)
#define  MC_REG_OPENLOOP                 ((32U << ELT_IDENTIFIER_POS) | TYPE_DATA_8BIT)
#define  MC_REG_OPENLOOP_REVUP           ((33U << ELT_IDENTIFIER_POS) | TYPE_DATA_8BIT)
#define  MC_REG_OPENLOOP_VOLTFACTOR      ((34U << ELT_IDENTIFIER_POS) | TYPE_DATA_8BIT)
#define  MC_REG_OPENLOOP_SENSING         ((35U << ELT_IDENTIFIER_POS) | TYPE_DATA_8BIT)
#define  MC_REG_IPD_ENABLE               ((36U << ELT_IDENTIFIER_POS) | TYPE_DATA_8BIT)
#define  MC_REG_IPD_DEBUG                ((37U << ELT_IDENTIFIER_POS) | TYPE_DATA_8BIT)

/* TYPE_DATA_16BIT registers definition */
#define  MC_REG_SPEED_KP                 ((2U << ELT_IDENTIFIER_POS) | TYPE_DATA_16BIT)
#define  MC_REG_SPEED_KI                 ((3U << ELT_IDENTIFIER_POS) | TYPE_DATA_16BIT)
#define  MC_REG_SPEED_KD                 ((4U << ELT_IDENTIFIER_POS) | TYPE_DATA_16BIT)
#define  MC_REG_I_Q_KP                   ((6U << ELT_IDENTIFIER_POS) | TYPE_DATA_16BIT)
#define  MC_REG_I_Q_KI                   ((7U << ELT_IDENTIFIER_POS) | TYPE_DATA_16BIT)
#define  MC_REG_I_Q_KD                   ((8U << ELT_IDENTIFIER_POS) | TYPE_DATA_16BIT)
#define  MC_REG_I_D_KP                   ((10U << ELT_IDENTIFIER_POS) | TYPE_DATA_16BIT)
#define  MC_REG_I_D_KI                   ((11U << ELT_IDENTIFIER_POS) | TYPE_DATA_16BIT)
#define  MC_REG_I_D_KD                   ((12U << ELT_IDENTIFIER_POS) | TYPE_DATA_16BIT)
#define  MC_REG_STOPLL_C1                ((13U << ELT_IDENTIFIER_POS) | TYPE_DATA_16BIT)
#define  MC_REG_STOPLL_C2                ((14U << ELT_IDENTIFIER_POS) | TYPE_DATA_16BIT)
#define  MC_REG_STOCORDIC_C1             ((15U << ELT_IDENTIFIER_POS) | TYPE_DATA_16BIT)
#define  MC_REG_STOCORDIC_C2             ((16U << ELT_IDENTIFIER_POS) | TYPE_DATA_16BIT)
#define  MC_REG_STOPLL_KI                ((17U << ELT_IDENTIFIER_POS) | TYPE_DATA_16BIT)
#define  MC_REG_STOPLL_KP                ((18U << ELT_IDENTIFIER_POS) | TYPE_DATA_16BIT)
#define  MC_REG_FLUXWK_KP                ((19U << ELT_IDENTIFIER_POS) | TYPE_DATA_16BIT)
#define  MC_REG_FLUXWK_KI                ((20U << ELT_IDENTIFIER_POS) | TYPE_DATA_16BIT)
#define  MC_REG_FLUXWK_BUS               ((21U << ELT_IDENTIFIER_POS) | TYPE_DATA_16BIT)
#define  MC_REG_BUS_VOLTAGE              ((22U << ELT_IDENTIFIER_POS) | TYPE_DATA_16BIT)
#define  MC_REG_HEATS_TEMP               ((23U << ELT_IDENTIFIER_POS) | TYPE_DATA_16BIT)
#define  MC_REG_DAC_OUT1                 ((25U << ELT_IDENTIFIER_POS) | TYPE_DATA_16BIT)
#define  MC_REG_DAC_OUT2                 ((26U << ELT_IDENTIFIER_POS) | TYPE_DATA_16BIT)
#define  MC_REG_DAC_OUT3                 ((27 << ELT_IDENTIFIER_POS) | TYPE_DATA_16BIT)
#define  MC_REG_FLUXWK_BUS_MEAS          ((30U << ELT_IDENTIFIER_POS) | TYPE_DATA_16BIT)
#define  MC_REG_I_A                      ((31U << ELT_IDENTIFIER_POS) | TYPE_DATA_16BIT)
#define  MC_REG_I_B                      ((32U << ELT_IDENTIFIER_POS) | TYPE_DATA_16BIT)
#define  MC_REG_I_ALPHA_MEAS             ((33U << ELT_IDENTIFIER_POS) | TYPE_DATA_16BIT)
#define  MC_REG_I_BETA_MEAS              ((34U << ELT_IDENTIFIER_POS) | TYPE_DATA_16BIT)
#define  MC_REG_I_Q_MEAS                 ((35U << ELT_IDENTIFIER_POS) | TYPE_DATA_16BIT)
#define  MC_REG_I_D_MEAS                 ((36U << ELT_IDENTIFIER_POS) | TYPE_DATA_16BIT)
#define  MC_REG_I_Q_REF                  ((37U << ELT_IDENTIFIER_POS) | TYPE_DATA_16BIT)
#define  MC_REG_I_D_REF                  ((38U << ELT_IDENTIFIER_POS) | TYPE_DATA_16BIT)
#define  MC_REG_V_Q                      ((39U << ELT_IDENTIFIER_POS) | TYPE_DATA_16BIT)
#define  MC_REG_V_D                      ((40U << ELT_IDENTIFIER_POS) | TYPE_DATA_16BIT)
#define  MC_REG_V_ALPHA                  ((41U << ELT_IDENTIFIER_POS) | TYPE_DATA_16BIT)
#define  MC_REG_V_BETA                   ((42U << ELT_IDENTIFIER_POS) | TYPE_DATA_16BIT)
#define  MC_REG_ENCODER_EL_ANGLE         ((43 << ELT_IDENTIFIER_POS) | TYPE_DATA_16BIT)
#define  MC_REG_ENCODER_SPEED            ((44 << ELT_IDENTIFIER_POS) | TYPE_DATA_16BIT)
#define  MC_REG_STOPLL_EL_ANGLE          ((45U << ELT_IDENTIFIER_POS) | TYPE_DATA_16BIT)
#define  MC_REG_STOPLL_ROT_SPEED         ((46U << ELT_IDENTIFIER_POS) | TYPE_DATA_16BIT)
#define  MC_REG_STOPLL_I_ALPHA           ((47U << ELT_IDENTIFIER_POS) | TYPE_DATA_16BIT)
#define  MC_REG_STOPLL_I_BETA            ((48U << ELT_IDENTIFIER_POS) | TYPE_DATA_16BIT)
#define  MC_REG_STOPLL_BEMF_ALPHA        ((49U << ELT_IDENTIFIER_POS) | TYPE_DATA_16BIT)
#define  MC_REG_STOPLL_BEMF_BETA         ((50U << ELT_IDENTIFIER_POS) | TYPE_DATA_16BIT)
#define  MC_REG_STOCORDIC_EL_ANGLE       ((51 << ELT_IDENTIFIER_POS) | TYPE_DATA_16BIT)
#define  MC_REG_STOCORDIC_ROT_SPEED      ((52 << ELT_IDENTIFIER_POS) | TYPE_DATA_16BIT)
#define  MC_REG_STOCORDIC_I_ALPHA        ((53 << ELT_IDENTIFIER_POS) | TYPE_DATA_16BIT)
#define  MC_REG_STOCORDIC_I_BETA         ((54 << ELT_IDENTIFIER_POS) | TYPE_DATA_16BIT)
#define  MC_REG_STOCORDIC_BEMF_ALPHA     ((55 << ELT_IDENTIFIER_POS) | TYPE_DATA_16BIT)
#define  MC_REG_STOCORDIC_BEMF_BETA      ((56 << ELT_IDENTIFIER_POS) | TYPE_DATA_16BIT)
#define  MC_REG_DAC_USER1                ((57U << ELT_IDENTIFIER_POS) | TYPE_DATA_16BIT)
#define  MC_REG_DAC_USER2                ((58U << ELT_IDENTIFIER_POS) | TYPE_DATA_16BIT)
#define  MC_REG_HALL_EL_ANGLE            ((59 << ELT_IDENTIFIER_POS) | TYPE_DATA_16BIT)
#define  MC_REG_HALL_SPEED               ((60 << ELT_IDENTIFIER_POS) | TYPE_DATA_16BIT)
#define  MC_REG_FF_VQ                    ((62U << ELT_IDENTIFIER_POS) | TYPE_DATA_16BIT)
#define  MC_REG_FF_VD                    ((63U << ELT_IDENTIFIER_POS) | TYPE_DATA_16BIT)
#define  MC_REG_FF_VQ_PIOUT              ((64U << ELT_IDENTIFIER_POS) | TYPE_DATA_16BIT)
#define  MC_REG_FF_VD_PIOUT              ((65U << ELT_IDENTIFIER_POS) | TYPE_DATA_16BIT)
#define  MC_REG_PFC_DCBUS_REF            ((66U << ELT_IDENTIFIER_POS) | TYPE_DATA_16BIT)
#define  MC_REG_PFC_DCBUS_MEAS           ((67U << ELT_IDENTIFIER_POS) | TYPE_DATA_16BIT)
#define  MC_REG_PFC_ACBUS_FREQ           ((68U << ELT_IDENTIFIER_POS) | TYPE_DATA_16BIT)
#define  MC_REG_PFC_ACBUS_RMS            ((69U << ELT_IDENTIFIER_POS) | TYPE_DATA_16BIT)
#define  MC_REG_PFC_I_KP                 ((70U << ELT_IDENTIFIER_POS) | TYPE_DATA_16BIT)
#define  MC_REG_PFC_I_KI                 ((71U << ELT_IDENTIFIER_POS) | TYPE_DATA_16BIT)
#define  MC_REG_PFC_I_KD                 ((72U << ELT_IDENTIFIER_POS) | TYPE_DATA_16BIT)
#define  MC_REG_PFC_V_KP                 ((73U << ELT_IDENTIFIER_POS) | TYPE_DATA_16BIT)
#define  MC_REG_PFC_V_KI                 ((74U << ELT_IDENTIFIER_POS) | TYPE_DATA_16BIT)
#define  MC_REG_PFC_V_KD                 ((75U << ELT_IDENTIFIER_POS) | TYPE_DATA_16BIT)
#define  MC_REG_PFC_STARTUP_DURATION     ((76U << ELT_IDENTIFIER_POS) | TYPE_DATA_16BIT)
#define  MC_REG_SC_PWM_FREQUENCY         ((77 << ELT_IDENTIFIER_POS) | TYPE_DATA_16BIT)
#define  MC_REG_POSITION_KP              ((78 << ELT_IDENTIFIER_POS) | TYPE_DATA_16BIT)
#define  MC_REG_POSITION_KI              ((79 << ELT_IDENTIFIER_POS) | TYPE_DATA_16BIT)
#define  MC_REG_POSITION_KD              ((80 << ELT_IDENTIFIER_POS) | TYPE_DATA_16BIT)
#define  MC_REG_SPEED_KP_DIV             ((81 << ELT_IDENTIFIER_POS) | TYPE_DATA_16BIT)
#define  MC_REG_SPEED_KI_DIV             ((82 << ELT_IDENTIFIER_POS) | TYPE_DATA_16BIT)
#define  MC_REG_SPEED_KD_DIV             ((83 << ELT_IDENTIFIER_POS) | TYPE_DATA_16BIT)
#define  MC_REG_I_D_KP_DIV               ((84 << ELT_IDENTIFIER_POS) | TYPE_DATA_16BIT)
#define  MC_REG_I_D_KI_DIV               ((85 << ELT_IDENTIFIER_POS) | TYPE_DATA_16BIT)
#define  MC_REG_I_D_KD_DIV               ((86 << ELT_IDENTIFIER_POS) | TYPE_DATA_16BIT)
#define  MC_REG_I_Q_KP_DIV               ((87 << ELT_IDENTIFIER_POS) | TYPE_DATA_16BIT)
#define  MC_REG_I_Q_KI_DIV               ((88 << ELT_IDENTIFIER_POS) | TYPE_DATA_16BIT)
#define  MC_REG_I_Q_KD_DIV               ((89 << ELT_IDENTIFIER_POS) | TYPE_DATA_16BIT)
#define  MC_REG_POSITION_KP_DIV          ((90 << ELT_IDENTIFIER_POS) | TYPE_DATA_16BIT)
#define  MC_REG_POSITION_KI_DIV          ((91 << ELT_IDENTIFIER_POS) | TYPE_DATA_16BIT)
#define  MC_REG_POSITION_KD_DIV          ((92 << ELT_IDENTIFIER_POS) | TYPE_DATA_16BIT)
#define  MC_REG_PFC_I_KP_DIV             ((93 << ELT_IDENTIFIER_POS) | TYPE_DATA_16BIT)
#define  MC_REG_PFC_I_KI_DIV             ((94 << ELT_IDENTIFIER_POS) | TYPE_DATA_16BIT)
#define  MC_REG_PFC_I_KD_DIV             ((95 << ELT_IDENTIFIER_POS) | TYPE_DATA_16BIT)
#define  MC_REG_PFC_V_KP_DIV             ((96 << ELT_IDENTIFIER_POS) | TYPE_DATA_16BIT)
#define  MC_REG_PFC_V_KI_DIV             ((97 << ELT_IDENTIFIER_POS) | TYPE_DATA_16BIT)
#define  MC_REG_PFC_V_KD_DIV             ((98 << ELT_IDENTIFIER_POS) | TYPE_DATA_16BIT)
#define  MC_REG_STOPLL_KI_DIV            ((99 << ELT_IDENTIFIER_POS) | TYPE_DATA_16BIT)
#define  MC_REG_STOPLL_KP_DIV            ((100 << ELT_IDENTIFIER_POS) | TYPE_DATA_16BIT)
#define  MC_REG_FLUXWK_KP_DIV            ((101 << ELT_IDENTIFIER_POS) | TYPE_DATA_16BIT)
#define  MC_REG_FLUXWK_KI_DIV            ((102 << ELT_IDENTIFIER_POS) | TYPE_DATA_16BIT)
#define  MC_REG_STARTUP_CURRENT_REF      ((105 << ELT_IDENTIFIER_POS) | TYPE_DATA_16BIT)
#define  MC_REG_PULSE_VALUE              ((106 << ELT_IDENTIFIER_POS) | TYPE_DATA_16BIT)
#define  MC_REG_FOC_VQREF                ((107 << ELT_IDENTIFIER_POS) | TYPE_DATA_16BIT)
#define  MC_REG_OPENLOOP_CURRFACTOR      ((108U << ELT_IDENTIFIER_POS) | TYPE_DATA_16BIT)
#define  MC_REG_CURR_MONITOR             ((109U << ELT_IDENTIFIER_POS) | TYPE_DATA_16BIT)
#define  MC_REG_CURR_MONITOR_SAMPL_NS    ((110U << ELT_IDENTIFIER_POS) | TYPE_DATA_16BIT)
#define  MC_REG_CURR_MONITOR_AVG         ((111U << ELT_IDENTIFIER_POS) | TYPE_DATA_16BIT)
#define  MC_REG_OVERVOLTAGETHRESHOLD     ((112U << ELT_IDENTIFIER_POS) | TYPE_DATA_16BIT)
#define  MC_REG_UNDERVOLTAGETHRESHOLD    ((113U << ELT_IDENTIFIER_POS) | TYPE_DATA_16BIT)
#define  MC_REG_IPD_VSTR                 ((114U << ELT_IDENTIFIER_POS) | TYPE_DATA_16BIT)
#define  MC_REG_OPENLOOP_EL_ANGLE        ((115U << ELT_IDENTIFIER_POS) | TYPE_DATA_16BIT)
#define  MC_REG_IPD_VSTPTR               ((116U << ELT_IDENTIFIER_POS) | TYPE_DATA_16BIT)

/* TYPE_DATA_32BIT registers definition */
#define  MC_REG_FAULTS_FLAGS             ((0 << ELT_IDENTIFIER_POS) | TYPE_DATA_32BIT)
#define  MC_REG_SPEED_MEAS               ((1 << ELT_IDENTIFIER_POS) | TYPE_DATA_32BIT)
#define  MC_REG_SPEED_REF                ((2 << ELT_IDENTIFIER_POS) | TYPE_DATA_32BIT)
#define  MC_REG_STOPLL_EST_BEMF          ((3 << ELT_IDENTIFIER_POS) | TYPE_DATA_32BIT) /* To check shifted by >> 16*/
#define  MC_REG_STOPLL_OBS_BEMF          ((4 << ELT_IDENTIFIER_POS) | TYPE_DATA_32BIT) /* To check shifted by >> 16*/
#define  MC_REG_STOCORDIC_EST_BEMF       ((5 << ELT_IDENTIFIER_POS) | TYPE_DATA_32BIT) /* To check shifted by >> 16*/
#define  MC_REG_STOCORDIC_OBS_BEMF       ((6 << ELT_IDENTIFIER_POS) | TYPE_DATA_32BIT) /* To check shifted by >> 16*/
#define  MC_REG_FF_1Q                    ((7 << ELT_IDENTIFIER_POS) | TYPE_DATA_32BIT) /* To check shifted by >> 16*/
#define  MC_REG_FF_1D                    ((8 << ELT_IDENTIFIER_POS) | TYPE_DATA_32BIT) /* To check shifted by >> 16*/
#define  MC_REG_FF_2                     ((9 << ELT_IDENTIFIER_POS) | TYPE_DATA_32BIT) /* To check shifted by >> 16*/
#define  MC_REG_PFC_FAULTS               ((40 << ELT_IDENTIFIER_POS) | TYPE_DATA_32BIT)
#define  MC_REG_CURRENT_POSITION         ((41 << ELT_IDENTIFIER_POS) | TYPE_DATA_32BIT)
#define  MC_REG_SC_RS                    ((91 << ELT_IDENTIFIER_POS) | TYPE_DATA_32BIT)
#define  MC_REG_SC_LS                    ((92 << ELT_IDENTIFIER_POS) | TYPE_DATA_32BIT)
#define  MC_REG_SC_KE                    ((93 << ELT_IDENTIFIER_POS) | TYPE_DATA_32BIT)
#define  MC_REG_SC_VBUS                  ((94 << ELT_IDENTIFIER_POS) | TYPE_DATA_32BIT)
#define  MC_REG_SC_MEAS_NOMINALSPEED     ((95 << ELT_IDENTIFIER_POS) | TYPE_DATA_32BIT)
#define  MC_REG_SC_CURRENT               ((96 << ELT_IDENTIFIER_POS) | TYPE_DATA_32BIT)
#define  MC_REG_SC_SPDBANDWIDTH          ((97 << ELT_IDENTIFIER_POS) | TYPE_DATA_32BIT)
#define  MC_REG_SC_LDLQRATIO             ((98 << ELT_IDENTIFIER_POS) | TYPE_DATA_32BIT)
#define  MC_REG_SC_NOMINAL_SPEED         ((99 << ELT_IDENTIFIER_POS) | TYPE_DATA_32BIT)
#define  MC_REG_SC_CURRBANDWIDTH         ((100 << ELT_IDENTIFIER_POS) | TYPE_DATA_32BIT)
#define  MC_REG_SC_J                     ((101 << ELT_IDENTIFIER_POS) | TYPE_DATA_32BIT)
#define  MC_REG_SC_F                     ((102 << ELT_IDENTIFIER_POS) | TYPE_DATA_32BIT)
#define  MC_REG_SC_MAX_CURRENT           ((103 << ELT_IDENTIFIER_POS) | TYPE_DATA_32BIT)
#define  MC_REG_SC_STARTUP_SPEED         ((104 << ELT_IDENTIFIER_POS) | TYPE_DATA_32BIT)
#define  MC_REG_SC_STARTUP_ACC           ((105 << ELT_IDENTIFIER_POS) | TYPE_DATA_32BIT)
#define  MC_REG_RESISTOR_OFFSET          ((116 << ELT_IDENTIFIER_POS) | TYPE_DATA_32BIT)

#define  MC_REG_MOTOR_POWER              ((109 << ELT_IDENTIFIER_POS) | TYPE_DATA_32BIT)

#define  MC_REG_FW_NAME                  ((0U << ELT_IDENTIFIER_POS) | TYPE_DATA_STRING)
#define  MC_REG_CTRL_STAGE_NAME          ((1U << ELT_IDENTIFIER_POS) | TYPE_DATA_STRING)
#define  MC_REG_PWR_STAGE_NAME           ((2U << ELT_IDENTIFIER_POS) | TYPE_DATA_STRING)
#define  MC_REG_MOTOR_NAME               ((3U << ELT_IDENTIFIER_POS) | TYPE_DATA_STRING)

#define  MC_REG_GLOBAL_CONFIG            ((0U << ELT_IDENTIFIER_POS) | TYPE_DATA_RAW)
#define  MC_REG_MOTOR_CONFIG             ((1U << ELT_IDENTIFIER_POS) | TYPE_DATA_RAW)
#define  MC_REG_APPLICATION_CONFIG       ((2U << ELT_IDENTIFIER_POS) | TYPE_DATA_RAW)
#define  MC_REG_FOCFW_CONFIG             ((3U << ELT_IDENTIFIER_POS) | TYPE_DATA_RAW)
#define  MC_REG_SCALE_CONFIG             ((4U << ELT_IDENTIFIER_POS) | TYPE_DATA_RAW)
#define  MC_REG_SPEED_RAMP               ((6U << ELT_IDENTIFIER_POS) | TYPE_DATA_RAW)
#define  MC_REG_TORQUE_RAMP              ((7U << ELT_IDENTIFIER_POS) | TYPE_DATA_RAW)
#define  MC_REG_REVUP_DATA               ((8U << ELT_IDENTIFIER_POS) | TYPE_DATA_RAW) /* Configure all steps*/
#define  MC_REG_CURRENT_REF              ((13U << ELT_IDENTIFIER_POS) | TYPE_DATA_RAW)
#define  MC_REG_POSITION_RAMP            ((14U << ELT_IDENTIFIER_POS) | TYPE_DATA_RAW)
#define  MC_REG_ASYNC_UARTA              ((20U << ELT_IDENTIFIER_POS) | TYPE_DATA_RAW)
#define  MC_REG_ASYNC_UARTB              ((21U << ELT_IDENTIFIER_POS) | TYPE_DATA_RAW)
#define  MC_REG_ASYNC_STLNK              ((22U << ELT_IDENTIFIER_POS) | TYPE_DATA_RAW)
#define  MC_REG_HT_HEW_PINS              ((28U << ELT_IDENTIFIER_POS) | TYPE_DATA_RAW)
#define  MC_REG_HT_CONNECTED_PINS        ((29U << ELT_IDENTIFIER_POS) | TYPE_DATA_RAW)
#define  MC_REG_HT_PHASE_SHIFT           ((30U << ELT_IDENTIFIER_POS) | TYPE_DATA_RAW)
#define  MC_REG_BEMF_ADC_CONF            ((31U << ELT_IDENTIFIER_POS) | TYPE_DATA_RAW)

uint8_t RI_SetRegisterGlobal(uint16_t regID, uint8_t typeID, uint8_t *data, uint16_t *size, int16_t dataAvailable);

uint8_t RI_SetRegisterMotor1(uint16_t regID,  uint8_t typeID,uint8_t *data, uint16_t *size, int16_t dataAvailable);

uint8_t RI_GetRegisterGlobal(uint16_t regID, uint8_t typeID, uint8_t * data, uint16_t *size, int16_t freeSpace);

uint8_t RI_GetRegisterMotor1(uint16_t regID, uint8_t typeID, uint8_t * data, uint16_t *size, int16_t freeSpace);

uint8_t RI_MovString(const char_t * srcString, char_t * destString, uint16_t *size, int16_t maxSize);

#endif /* REGISTER_INTERFACE_H */

/************************ (C) COPYRIGHT 2025 STMicroelectronics *****END OF FILE****/
