TijmenDC1/PE2-herexamen/code/extra/test6step/Src/mc_api.c

/**
  ******************************************************************************
  * @file    mc_api.c
  * @author  Motor Control SDK Team, ST Microelectronics
  * @brief   This file implements the high level interface of the Motor Control SDK.
  ******************************************************************************
  * @attention
  *
  * <h2><center>&copy; Copyright (c) 2025 STMicroelectronics.
  * All rights reserved.</center></h2>
  *
  * This software component is licensed by ST under Ultimate Liberty license
  * SLA0044, the "License"; You may not use this file except in compliance with
  * the License. You may obtain a copy of the License at:
  *                             www.st.com/SLA0044
  *
  ******************************************************************************
  * @ingroup MCIAPI
  */

#include "mc_interface.h"
#include "mc_api.h"
#include "mc_config.h"
#include "mcp.h"

/** @addtogroup MCSDK
  * @{
  */

/**
  * @defgroup CAI Application Programming Interface
  * @brief Interface for Motor Control applications using the classic SDK
  *
  * @{
  */

/** @defgroup MCIAPI Motor Control API
  *
  * @brief High level Programming Interface of the Motor Control SDK
  *
  *  This interface allows for performing basic operations on the motor(s) driven by an
  * Motor Control SDK based application. With it, motors can be started and stopped, speed or
  * torque ramps can be programmed and executed and information on the state of the motors can
  * be retrieved, among others.
  *
  *  This interface consists in functions that target a specific motor, indicated in their name.
  * These functions aims at being the main interface used by an Application to control motors.
  *
  *  The current Motor Control API can cope with up to 2 motors.
  * @{
  */

/**
  * @brief  Initiates the start-up procedure for Motor 1
  *
  *  If the state machine of Motor 1 is in #IDLE state, the command is immediately
  * executed. Otherwise the command is discarded. The Application can check the
  * return value to know whether the command was executed or discarded.
  *
  *  One of the following commands must be executed before calling MC_StartMotor1()
  * in order to set a torque or a speed reference:
  *
  * - MC_ProgramSpeedRampMotor1()
  * - MC_ProgramTorqueRampMotor1()
  * - MC_SetCurrentReferenceMotor1()
  *
  * Failing to do so results in an unpredictable behaviour.
  *
  * If the offsets of the current measurement circuitry offsets are not known yet,
  * an offset calibration procedure is executed to measure them prior to acutally
  * starting up the motor.
  *
  * @note The MCI_StartMotor1 command only triggers the execution of the start-up
  * procedure (or eventually the offset calibration procedure) and returns
  * immediately after. It is not blocking the execution of the application until
  * the motor is indeed running in steady state. If the application needs to wait
  * for the motor to be running in steady state, the application has to check the
  * state machine of the motor and verify that the #RUN state has been reached.
  * Note also that if the startup sequence fails the #RUN state may never be reached.
  *
  * @retval returns true if the command is successfully executed, false otherwise.
  */
__weak bool MC_StartMotor1(void)
{
  return (MCI_StartMotor(pMCI[M1]));
}

/**
  * @brief  Initiates the stop procedure for Motor 1.
  *
  *  If the state machine is in any state but the #ICLWAIT, #IDLE, FAULT_NOW and
  * #FAULT_OVER states, the command is immediately executed. Otherwise, it is
  * discarded. The Application can check the return value to know whether the
  * command was executed or discarded.
  *
  * @note The MC_StopMotor1() command only triggers the stop motor procedure
  * and then returns. It is not blocking the application until the motor is indeed
  * stopped. To know if it has stopped, the application can query the motor's state
  * machine and check if the #IDLE state has been reached.
  *
  * @retval returns true if the command is successfully executed, false otherwise.
  */
__weak bool MC_StopMotor1(void)
{
  return (MCI_StopMotor(pMCI[M1]));
}

/**
  * @brief Programs a speed ramp for Motor 1 for later or immediate execution.
  *
  *  A speed ramp is a linear change from the current speed reference to the @p hFinalSpeed
  * target speed in the given @p hDurationms time.
  *
  *  Invoking the MC_ProgramSpeedRampMotor1() function programs a new speed ramp
  * with the provided parameters. The programmed ramp is executed immediately if
  * Motor 1's state machine is in the #RUN states. Otherwise, the ramp is buffered
  * and will be executed when the state machine reaches any of the aforementioned state.
  *
  *  The Application can check the status of the command with the MC_GetCommandStateMotor1()
  * to know whether the last command was executed immediately or not.
  *
  * Only one command can be buffered at any given time. If another ramp - whether a
  * speed or a torque one - or if another buffered command is programmed before the
  * current one has completed, the latter replaces the former.
  *
  * @note A ramp cannot reverse the rotation direction if the Application is using
  * sensorless motor control techniques. If the sign of the hFinalSpeed parameter
  * differs from that of the current speed, the ramp will not complete and a Speed
  * Feedback error (#MC_SPEED_FDBK) will occur when the rotation speed is about to
  * reach 0 rpm.
  *
  * @param  hFinalSpeed Mechanical rotor speed reference at the end of the ramp.
  *                     Expressed in the unit defined by #SPEED_UNIT.
  * @param  hDurationms Duration of the ramp expressed in milliseconds. It
  *         is possible to set 0 to perform an instantaneous change in the speed
  *         value.
  */
__weak void MC_ProgramSpeedRampMotor1(int16_t hFinalSpeed, uint16_t hDurationms)
{
  MCI_ExecSpeedRamp(pMCI[M1], hFinalSpeed, hDurationms);
}

/**
 * @brief returns the electrical torque reference for Motor 1
 */
__weak int16_t MCI_GetDutyCycleRefMotor1(void)
{
  return ((int16_t)MCI_GetDutyCycleRef(pMCI[M1]));
}

/**
  * @brief  Returns the status of the last buffered command for Motor 1.
  *
  * The status can be one of the following values:
  * - #MCI_BUFFER_EMPTY: no buffered command is currently programmed.
  * - #MCI_COMMAND_NOT_ALREADY_EXECUTED: A command has been buffered but the conditions for its
  *   execution have not occurred yet. The command is still in the buffer, pending execution.
  * - #MCI_COMMAND_EXECUTED_SUCCESSFULLY: the last buffered command has been executed successfully.
  *   In this case calling this function resets the command state to #MCI_BUFFER_EMPTY.
  * - #MCI_COMMAND_EXECUTED_UNSUCCESSFULLY: the buffered command has been executed unsuccessfully.
  *   In this case calling this function resets the command state to #MCI_BUFFER_EMPTY.
  */
__weak MCI_CommandState_t  MC_GetCommandStateMotor1(void)
{
  return (MCI_IsCommandAcknowledged(pMCI[M1]));
}

/**
 * @brief Stops the execution of the on-going speed ramp for Motor 1, if any.
 *
 *  If a speed ramp is currently being executed, it is immediately stopped, the rotation
 * speed of Motor 1 is maintained to its current value and true is returned. If no speed
 * ramp is on-going, nothing is done and false is returned.
 *
 * @deprecated This function is deprecated and should not be used anymore. It will be
 *             removed in a future version of the MCSDK. Use MC_StopRampMotor1() instead.
 */
__weak bool MC_StopSpeedRampMotor1(void)
{
  return (MCI_StopSpeedRamp(pMCI[M1]));
}

/**
 * @brief Stops the execution of the on-going ramp for Motor 1, if any.
 *
 *  If a ramp is currently being executed, it is immediately stopped, the torque or the speed
 *  of Motor 1 is maintained to its current value.
 */
__weak void MC_StopRampMotor1(void)
{
  MCI_StopRamp(pMCI[M1]);
}

/**
 * @brief Returns true if the last ramp submited for Motor 1 has completed, false otherwise
 */
__weak bool MC_HasRampCompletedMotor1(void)
{
  return (MCI_RampCompleted(pMCI[M1]));
}

/**
 *  @brief Returns the current mechanical rotor speed reference set for Motor 1, expressed in the unit defined by #SPEED_UNIT
 */
__weak int16_t MC_GetMecSpeedReferenceMotor1(void)
{
  return (MCI_GetMecSpeedRefUnit(pMCI[M1]));
}

/**
 *  @brief Returns the current mechanical rotor speed reference set for Motor 1, expressed in rpm.
 */
__weak float_t MC_GetMecSpeedReferenceMotor1_F(void)
{
  return (MCI_GetMecSpeedRef_F(pMCI[M1]));
}

/**
 * @brief Returns the last computed average mechanical rotor speed for Motor 1, expressed in the unit defined by #SPEED_UNIT
 */
__weak int16_t MC_GetMecSpeedAverageMotor1(void)
{
  return (MCI_GetAvrgMecSpeedUnit(pMCI[M1]));
}

/**
 * @brief Returns the last computed average mechanical rotor speed for Motor 1, expressed in rpm.
 */
__weak float_t MC_GetAverageMecSpeedMotor1_F(void)
{
  return (MCI_GetAvrgMecSpeed_F(pMCI[M1]));
}

/**
 * @brief Returns the final speed of the last ramp programmed for Motor 1 if this ramp was a speed ramp, 0 otherwise.
 */
__weak int16_t MC_GetLastRampFinalSpeedMotor1(void)
{
  return (MCI_GetLastRampFinalSpeed(pMCI[M1]));
}

/**
 * @brief Returns the final speed of the last ramp programmed for Motor 1 if this ramp was a speed ramp, 0 otherwise.
 */
__weak float_t MC_GetLastRampFinalSpeedM1_F(void)
{
  return (MCI_GetLastRampFinalSpeed_F(pMCI[M1]));
}
/**
 * @brief Returns the Control Mode used for Motor 1 (either Speed or Torque)
 */
__weak MC_ControlMode_t MC_GetControlModeMotor1(void)
{
  return (MCI_GetControlMode(pMCI[M1]));
}

/**
 * @brief Returns the rotation direction imposed by the last command on Motor 1
 *
 * The last command is either MC_ProgramSpeedRampMotor1(), MC_ProgramTorqueRampMotor1() or
 * MC_SetCurrentReferenceMotor1().
 *
 * The function returns -1 if the sign of the final speed, the final torque or the Iq current
 * reference component of the last command is negative. Otherwise, 1 is returned.
 *
 * @note if no such command has ever been submitted, 1 is returned as well.
 */
__weak int16_t MC_GetImposedDirectionMotor1(void)
{
  return (MCI_GetImposedMotorDirection(pMCI[M1]));
}

/**
 * @brief Returns true if the speed sensor used for Motor 1 is reliable, false otherwise
 */
__weak bool MC_GetSpeedSensorReliabilityMotor1(void)
{
  return (MCI_GetSpdSensorReliability(pMCI[M1]));
}

/**
 * @brief Acknowledge a Motor Control fault that occured on Motor 1
 *
 *  This function informs Motor 1's state machine that the Application has taken
 * the error condition that occured into account. If no error condition exists when
 * the function is called, nothing is done and false is returned. Otherwise, true is
 * returned.
 */
__weak bool MC_AcknowledgeFaultMotor1(void)
{
  return (MCI_FaultAcknowledged(pMCI[M1]));
}

/**
 * @brief Returns a bit-field showing non acknowledged faults that occurred on Motor 1.
 *
 * This function returns a 16 bit fields containing the Motor Control faults
 * that have occurred on Motor 1 since its state machine moved to the #FAULT_NOW state.
 *
 * See @ref fault_codes "Motor Control Faults" for a list of
 * of all possible faults codes.
 */
__weak uint16_t MC_GetOccurredFaultsMotor1(void)
{
  return (MCI_GetOccurredFaults(pMCI[M1]));
}

/**
 * @brief returns a bitfield showing all current faults on Motor 1
 *
 * This function returns a 16 bit fields containing the Motor Control faults
 * that are currently active.
 *
 * See @ref fault_codes "Motor Control Faults" for a list of
 * of all possible faults codes.
 */
__weak uint16_t MC_GetCurrentFaultsMotor1(void)
{
  return (MCI_GetCurrentFaults(pMCI[M1]));
}

/**
 * @brief returns the current state of Motor 1 state machine
 */
__weak MCI_State_t MC_GetSTMStateMotor1(void)
{
  return (MCI_GetSTMState(pMCI[M1]));
}

/**
 * @brief Not implemented MC_Profiler function.
 *  */ //cstat !MISRAC2012-Rule-2.7 !RED-unused-param  !MISRAC2012-Rule-2.7  !MISRAC2012-Rule-8.13
__weak uint8_t MC_ProfilerCommand(uint16_t rxLength, uint8_t *rxBuffer, int16_t txSyncFreeSpace, uint16_t *txLength, uint8_t *txBuffer)
{
  return (MCP_CMD_UNKNOWN);
}

/**
  * @}
  */

/**
  * @}
  */

/**
  * @}
  */

/************************ (C) COPYRIGHT 2025 STMicroelectronics *****END OF FILE****/
