TijmenDC1/PE2-herexamen/code/extra/test6step/Src/mcp.c

/**
  ******************************************************************************
  * @file    mcp.c
  * @author  Motor Control SDK Team, ST Microelectronics
  * @brief   This file provides firmware functions that implement the MCP protocol
  *
  *
  ******************************************************************************
  * @attention
  *
  * <h2><center>&copy; Copyright (c) 2025 STMicroelectronics.
  * All rights reserved.</center></h2>
  *
  * This software component is licensed by ST under Ultimate Liberty license
  * SLA0044, the "License"; You may not use this file except in compliance with
  * the License. You may obtain a copy of the License at:
  *                             www.st.com/SLA0044
  *
  ******************************************************************************
  */

#include "mc_type.h"
#include "mcp.h"
#include "register_interface.h"
#include "mc_config.h"
#include "mcp_config.h"
#include "mc_api.h"

/** @addtogroup MCSDK
  * @{
  */

/** @defgroup MCP Motor Control Protocol
  *
  * @brief Motor Control Protocol components of the Motor Control SDK.
  *
  * These components implement the features needed to drive and monitor motor control applications embedded in STM32 MCUs.
  * They mainly focus on the communication with the controller, both on the receiving and the transmitting end.
  *
  * @{
  */

/**
  * @brief  Parses the payload in the received packet and call the required function in order to modify a value.
  *
  * The function called depends on the targeted motor and/or targeted register : RI_SetRegisterGlobal or RI_SetRegisterMotorX.
  *
  * @param  pHandle Handler of the current instance of the MCP component
  * @param  txSyncFreeSpace Space available for synchronous transmission
  *
  * @retval Returns #MCP_CMD_OK if the command is acknowledged and #MCP_CMD_NOK if not.
  */
uint8_t RI_SetRegCommandParser (MCP_Handle_t * pHandle, uint16_t txSyncFreeSpace)
{
  uint8_t retVal = MCP_CMD_OK;
#ifdef NULL_PTR_CHECK_REG_INT
  if (MC_NULL == pHandle)
  {
    retVal = MCP_CMD_NOK;
  }
  else
  {
#endif
    uint16_t * dataElementID;
    uint8_t * rxData = pHandle->rxBuffer;
    uint8_t * txData = pHandle->txBuffer;
    int16_t rxLength = pHandle->rxLength;
    uint16_t size = 0U;
    uint8_t accessResult;

    uint16_t regID;
    uint8_t typeID;
    uint8_t motorID;
    uint8_t (*SetRegFcts[NBR_OF_MOTORS+1])(uint16_t, uint8_t, uint8_t*, uint16_t*, int16_t) = {&RI_SetRegisterGlobal, &RI_SetRegisterMotor1};
    uint8_t number_of_item =0;
    pHandle->txLength = 0;
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
