TijmenDC1/PE2-herexamen/(commit log)

2026-06-17 de git ignores voor altium toegevoegd
2026-06-17 al de bestaande code al toevoegen
2026-06-21 beetje geprutst aan de sensoren
2026-07-29 mpu6050 met FC en 4 Motors
    MPU6050 werkende die op pitch en roll ass de drone stabiel kan houden op de testopstelling
2026-07-30 sd kaart code verder afgewerkt nu wachten op pid om integratie te doen
2026-07-31 bmp barometer driver + test geschreven
2026-08-02 bmm350v2 geschreven en de scriptie verder geschreven
2026-08-02 Drone Frame
    [droneTest.f3d]
2026-08-07 versie 2 van het drone frame
    [droneTestv2.f3d]
2026-08-08 versie 2 van het frame met juiste afmetingen
    [droneTestv2.f3d, droneTestv2.f3z]
2026-08-11 motors en controller gecombineerd
2026-08-19 sd kaart en drone frame
    [droneframev3.f3z]
2026-08-19 ppt veranderingen + Drone frame naar .mf file
    [Configuration 1.3mf]
2026-08-20 SX1280 en mpu6050 laatste code
    [droneV3.3mf]
2026-08-20 aanpassingen bestanden toewijzing ppt
    [Autonoom.SchDoc, Controller.SchDoc, FC2.PcbDoc, Flight_Controller.PrjPcb, Flight_Controller.sdf, PCB1.PcbDoc, PCM12SMTBR.SchLib, Power.SchDoc]
