TijmenDC1/PE2-herexamen/(notices)

Notices in the files:
scriptie en voorstelling/sx1280Werkende/Core/Inc/main.h:
Copyright (c) 2026 STMicroelectronics.
All rights reserved.
This software is licensed under terms that can be found in the LICENSE file
code/GPS/Core/Inc/gps_ublox.h:
Cleanflight is free software: you can redistribute it and/or modify
it under the terms of the GNU General Public License as published by
the Free Software Foundation, either version 3 of the License, or
(at your option) any later version.
